spez1998/3rd-year-project/Submissions/constructed_pyle.jpeg

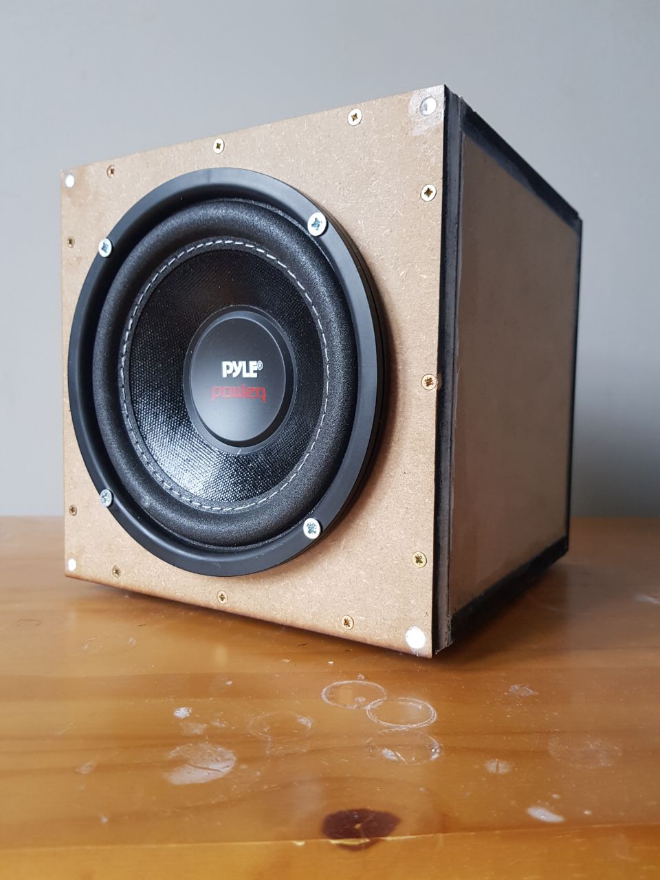
Submissions/constructed_pyle.jpeg
