spez1998/3rd-year-project/Design/SubsystemImages/PLPW6D.jpg

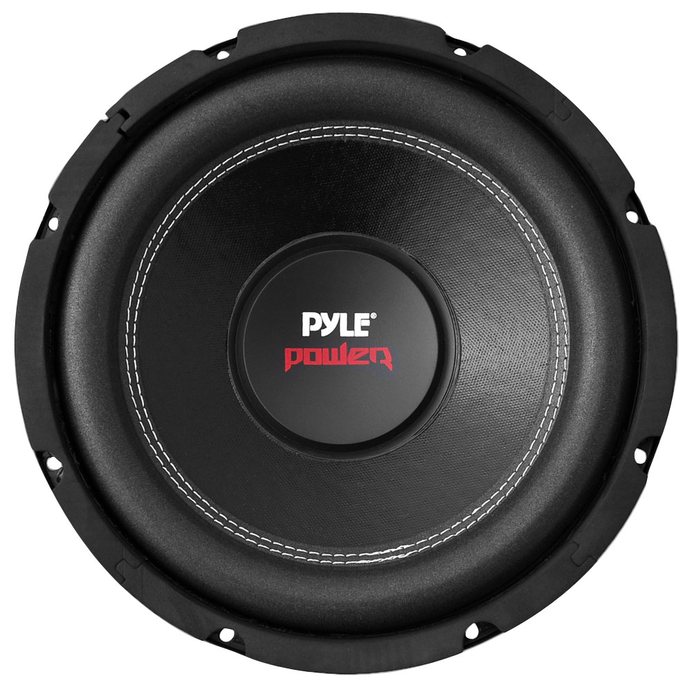
Design/SubsystemImages/PLPW6D.jpg
