spez1998/3rd-year-project/MeetingNotes/05_11_2019.docx

- Add opamp buffer between Linkwitz filters and speaker outputs.
- 196 ohm resistor exists to prevent short-circuited output from causing damage to filters
- Cable capacitance effects can also be mitigated by 196 ohm
