spez1998/3rd-year-project/Submissions/2ndMarkerViva/viva_presentation.pptx

## Motional Control of Loudspeakers

Sujit Malde, ela17sm, Electrical and Electronic Engineering 3rd Year Project
Second Marker Viva

## The Problem with Loudspeakers

- Not normally controlled
- Distortions and non-linearities are rife
- Expensive
  - Manufacturers must spend lots to make loudspeakers ‘perfect’
  - Most consumers can’t buy good audio

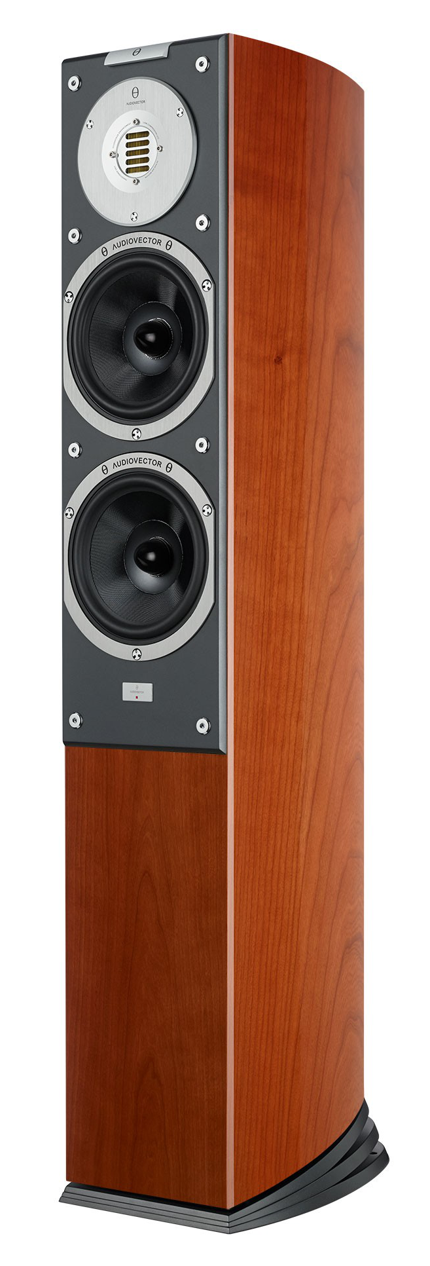
[picture p3: figure]

https://audiovector.com/sr-3-avantgarde-arrete.html

£12000 excluding rest of the system!

## The Problem with Loudspeakers

- Background theory shows that:
  - Subwoofers have the most non-linearities of all the loudspeakers
  - Subwoofers can have their bass response extended ’for free’
- Manufacturers already spending lots on R&D to make uncompensated systems sound good

Shown: typical poor subwoofer response, -15dB down at 20Hz

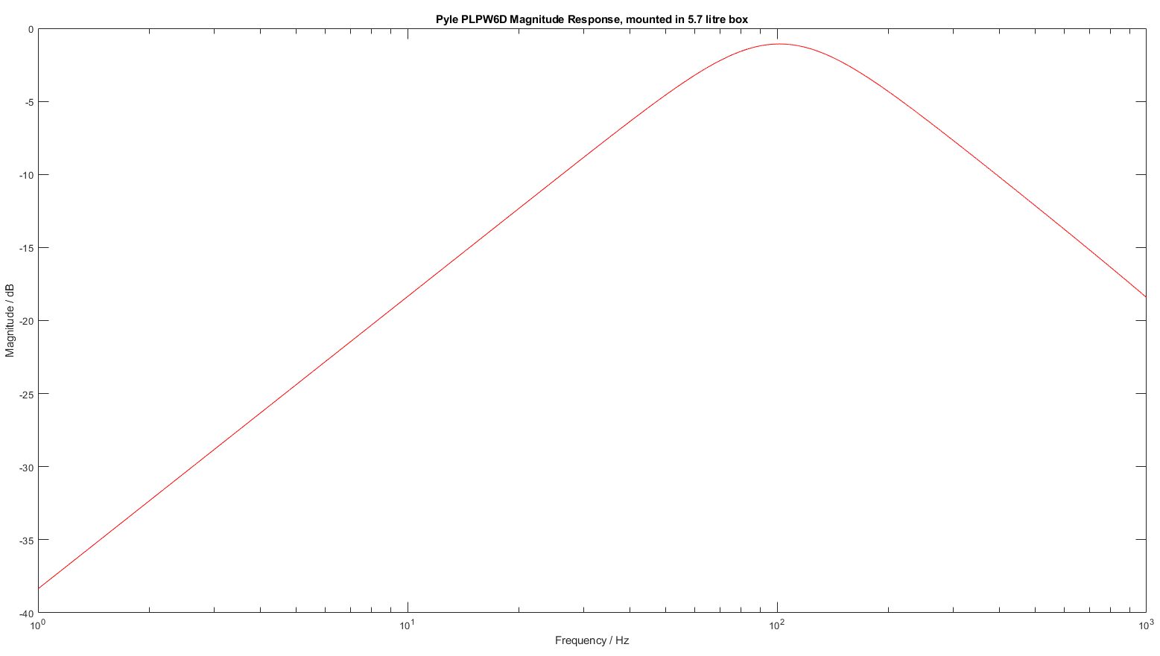
[picture p4: figure]

Frequency / Hz

10⁰

10¹

10²

10³

## The solution

- Open- and closed-loop compensators
- Electronic solution is cheap, easy to manufacture and install
- Fewer distortions, fewer non-linearities = cleaner sound reproductions
- ‘Free’ extension of bass response = better sound from the same physical system

## The process

Ideally:
1. Choose a subwoofer
2. Make an enclosure for the subwoofer
3. Open-loop compensator:
  a. Design
  b. Build
4. Closed-loop compensator:
  a. Design
  b. Build
5. Testing and tuning throughout

## Choosing a subwoofer

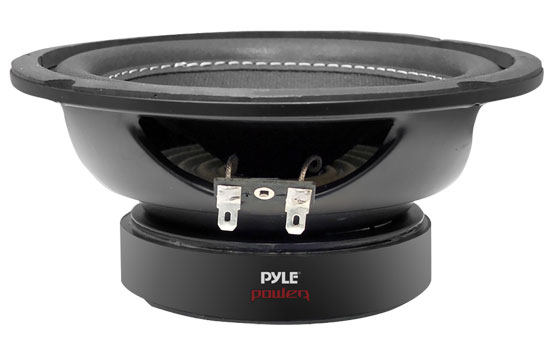
[picture p5: figure]

https://www.thompsonsltd.co.uk/touring-and-leisure/plpw6d-pyle-plpw6d-6.5-600-watt-dual-voice-coil-4-ohm-subwoofer.html

## Enclosure design

- Background theory shows that loudspeakers can be modelled as equivalent electrical circuits:

V_(in)

I

(C_(MS))/((Bl)^2)

(C_B)/((Bl)^2)

((Bl)^2)/(R_(MS))

((Bl)^2)/(R_B)

R_E

L_E

M_(MS) (Bl^2 )

Electrical and mechanical circuits can be thought of as primary and secondary of a transformer with turns ratio equivalent to Bl factor of driver magnet
Useful for SPICE/MATLAB but not easy information for end-users to digest – Thiele/Small parameters used instead

Red indicates voice coil circuit parameters
Blue indicates equivalent circuit parameters for the driver mechanical circuit
Green indicates equivalent circuit parameters for the box mechanical circuit

## Enclosure Design

1. Take T/S parameters from manufacturer
2. Convert to electromechanical equivalent circuit
3. Add in box circuit elements
4. Refine

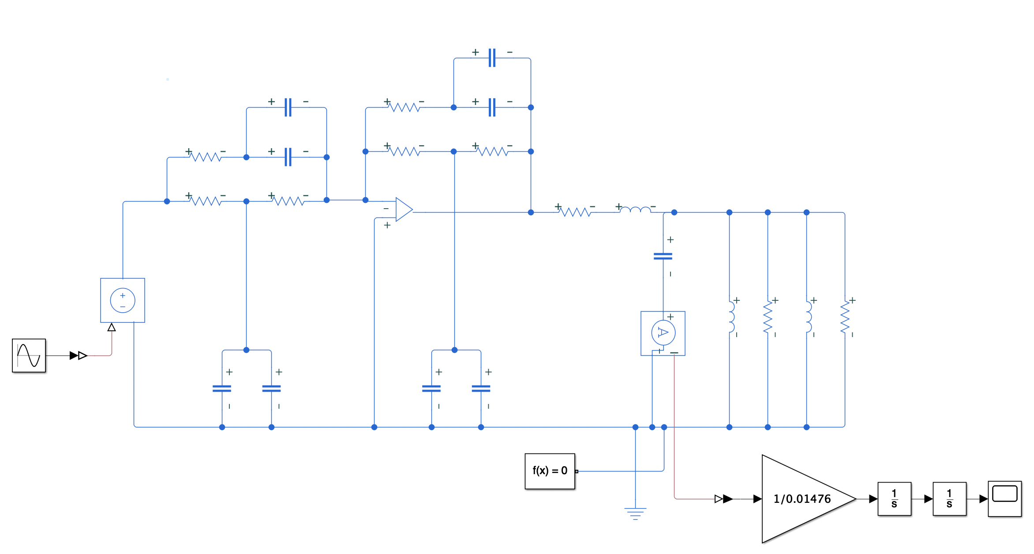
[picture p6: figure]

## Impedance Measurements

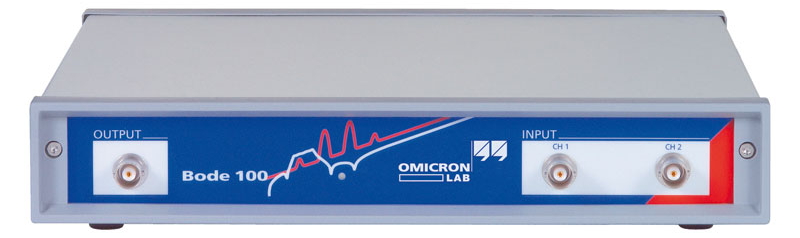
[picture p7: figure]
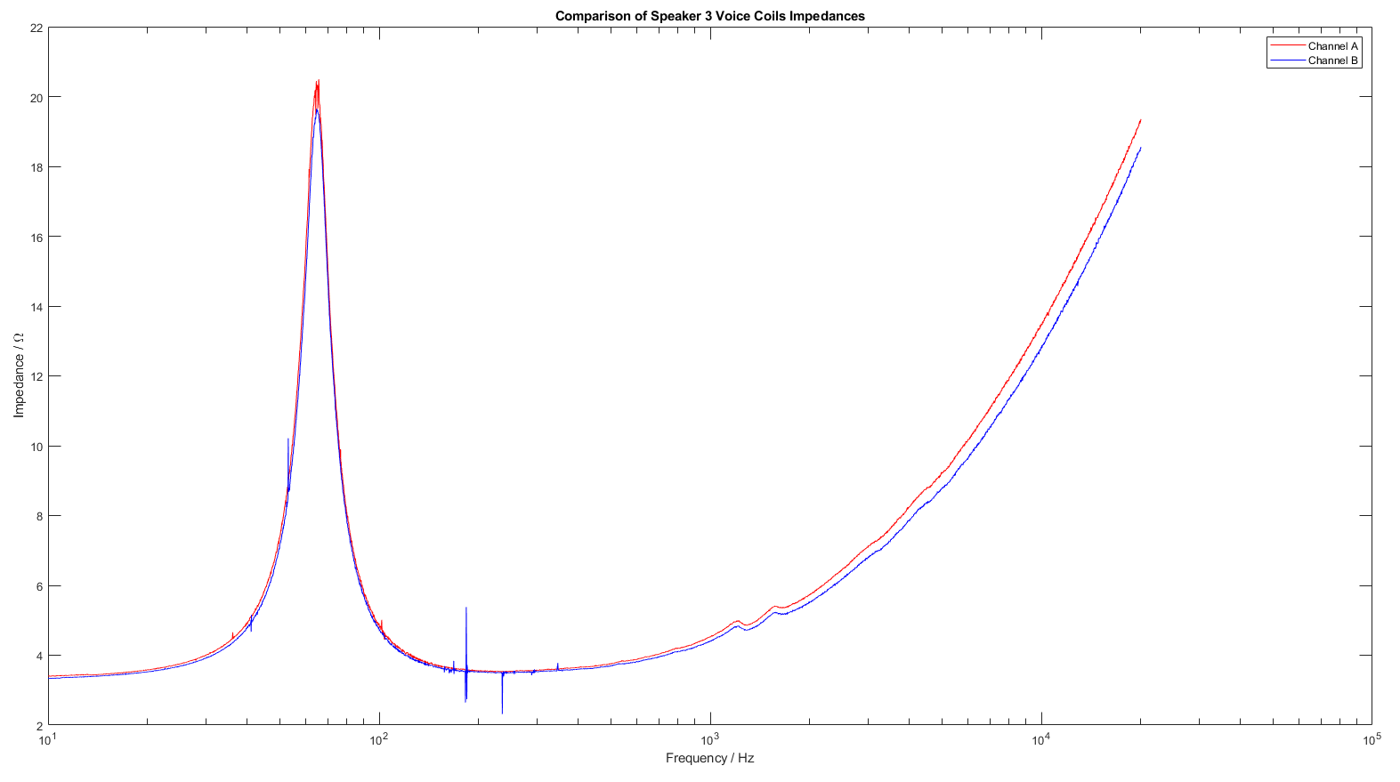
[picture p8: figure]

- All different permutation of connections were made and measured:
  - Series
  - Parallel (in 1 out 2)
  - Anti-parallel (in 2 out 1)
- Replace manufacturer given T/S parameters with these – also yields more accurate Bl

## Slide 10

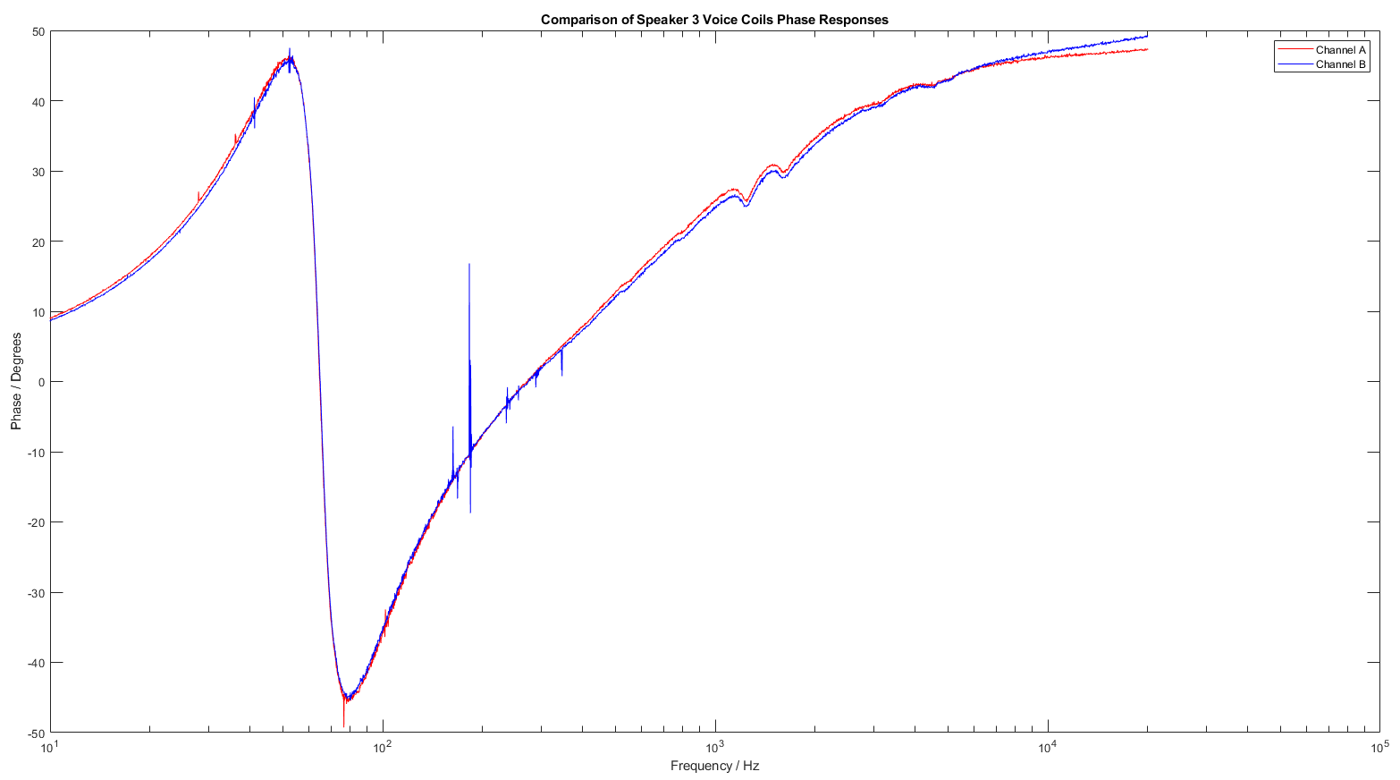
[picture p9: figure]

## Open-loop circuit design – Linkwitz Transform

- For a loudspeaker in an enclosure:
  - Brings up magnitude response
  - Reduces group delay
- Easy to design, made trivial using resources on the late designer’s website

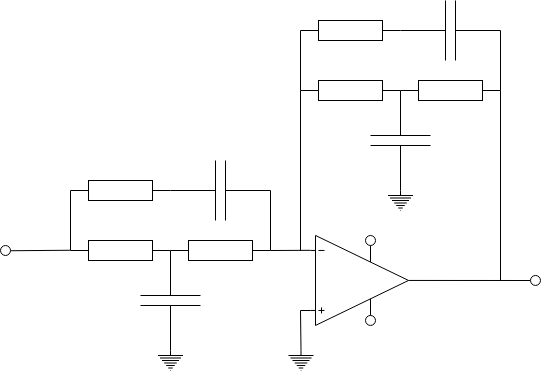
[picture p10: figure]

V_(in)

R_2

+V_s

−V_s

V_(out)

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
Gain / dB

f2

f1

f0

Frequency / Hz

Q0

f_0 =1/(2πR_1 √(C_1 C_2))
Q_0 =(R_1)/(2R_1 +R_2)√((C_1)/(C_2))
f_1 =1/(πR_1 C_1)
f_2 =1/(2π(R_2 +R_3 )C_2)

## Results

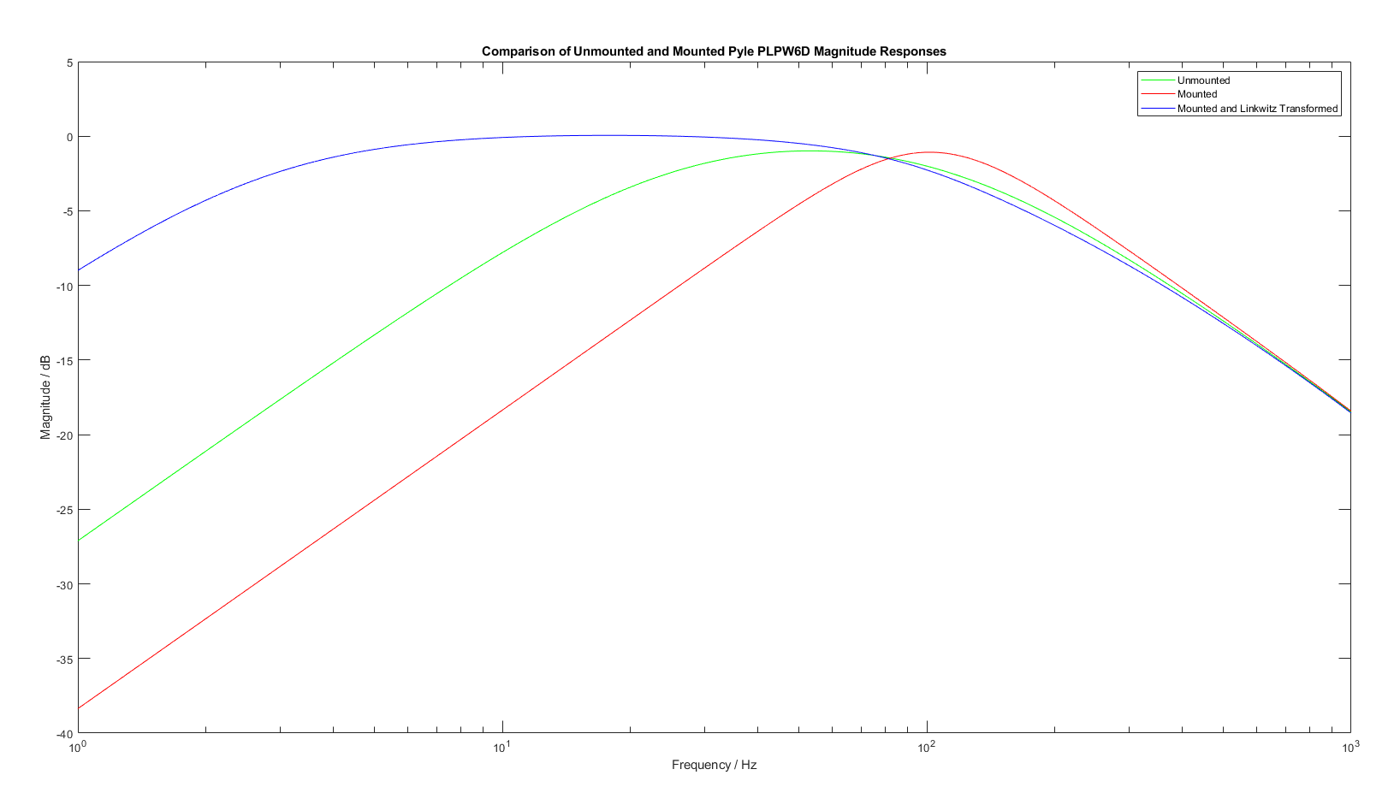
[picture p11: figure]

- Group delay of the system improved for most of the range of operation
- Improvement by as much as 2ms around 45Hz
- System will respond faster to an input, reach a nominal value faster

As expected, magnitude response improved massively at low frequencies
In practice this is unobtainable because too much air needs to be moved, cone displacement will exceed maximum allowed value

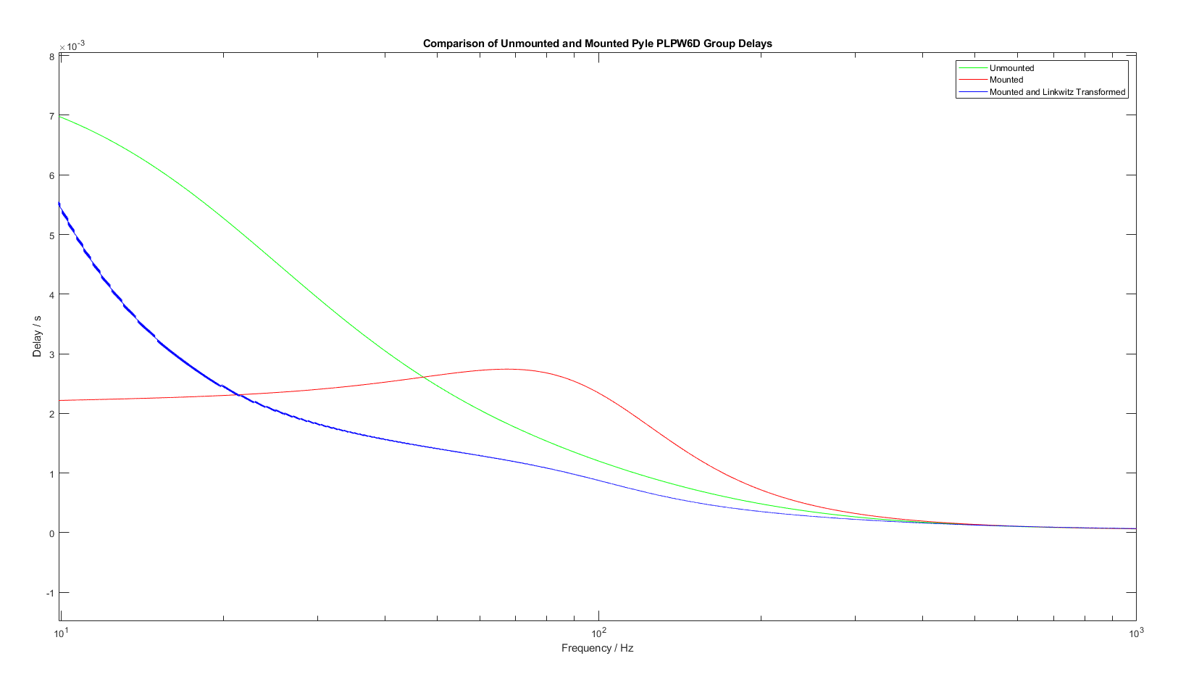
[picture p12: figure]

## Results

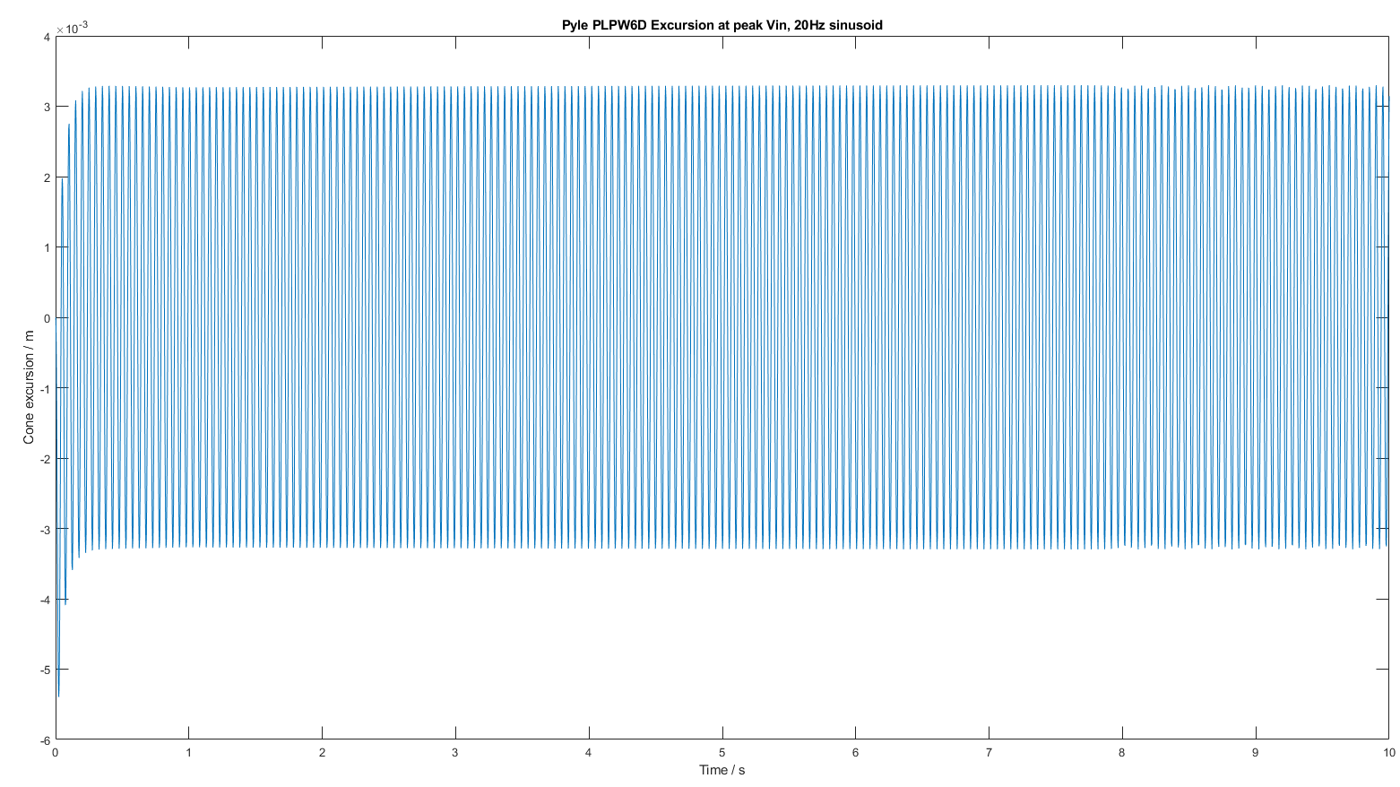
[picture p13: figure]

- Simulink model confirms that existing setup of Linkwitz Transform, driver, box does not exceed physical limitations
- Important result – LT may not have worked for this driver

## Plans

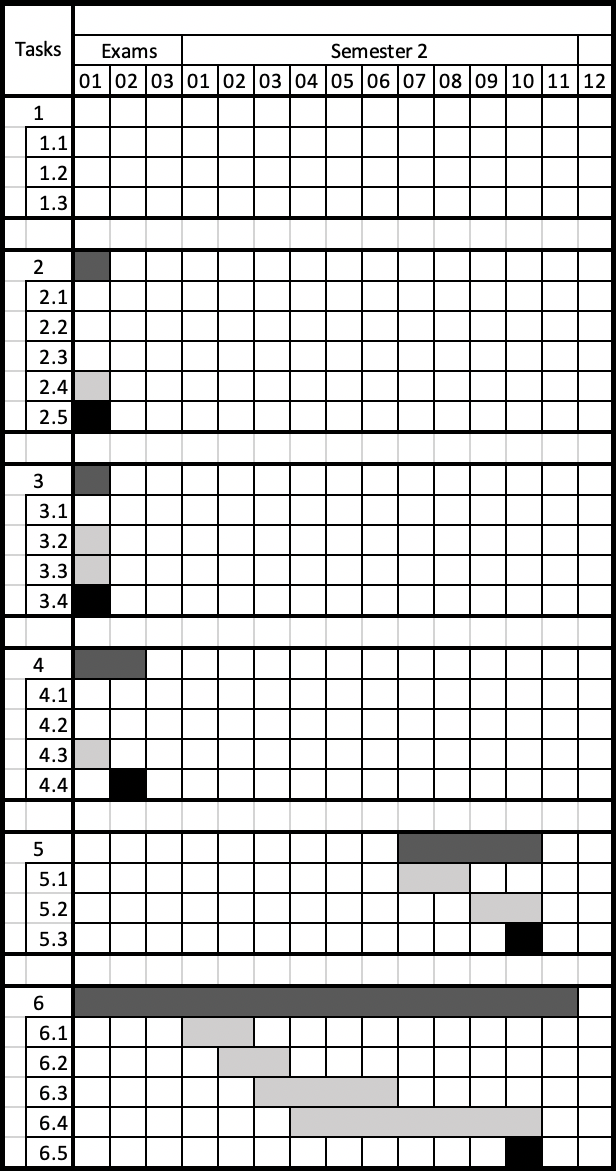
[picture p14: figure]

- Finish building subwoofer system
- Make and test open-loop compensator
- Design, simulate, build closed-loop compensators

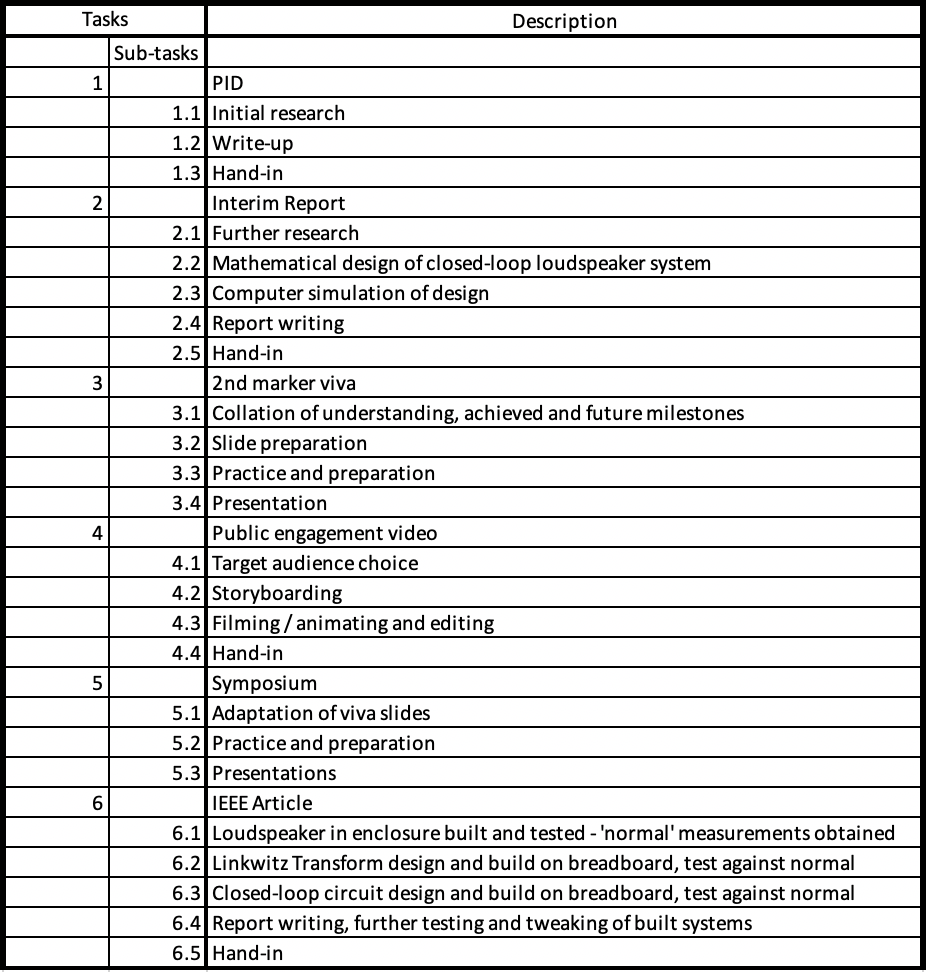
[picture p15: figure]
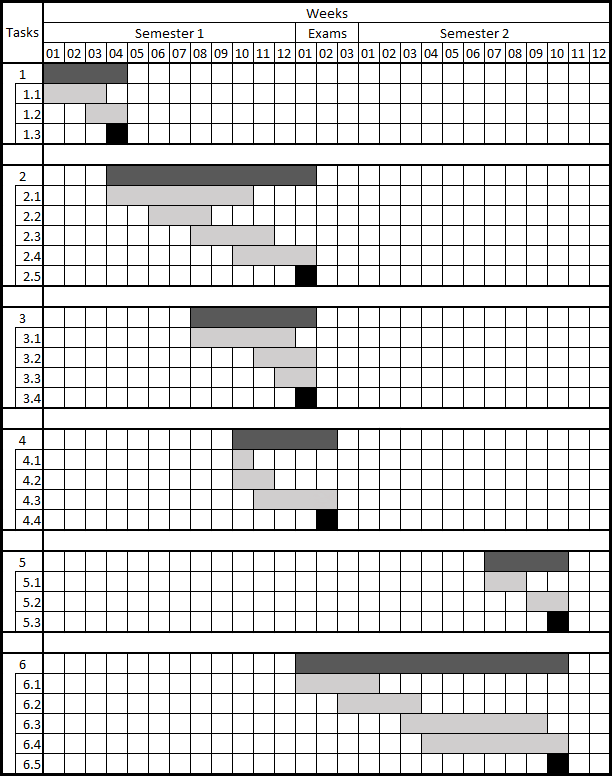
[picture p16: figure]

## Developing Technologies

- FPAA (e.g. as made by Anadigm) - easy interfacing with MATLAB/Simulink, mini DSP
- Different loudspeaker types other than simple coil-and-cone:
  - Electrostatic topology
  - Planar magnetic topology
Each has their own advantages and disadvantages
- Most useful innovations are patented!

## Slide 16

Thank you for listening, any questions?
