spez1998/3rd-year-project/Design/OpenLoop/LinkwitzLabsResources/Originals/spl_max1.xls

A) Excursion limited rms sound pressure level (SPL) for a driver in a closed box (monopole)
and in an open baffle (dipole) at 1 m distance on-axis, in free-space
Enter bold faced values for the driver under investigation, path difference and start frequency:
Add 6 dB to SPL for radiation into half-space.
 |  |  | 1252DVC | 21W/8554
 |  |  | Driver A | Driver B
 |  | Effective piston area Sd = | 530 | 200 | cm^2
 |  | Peak excursion Xmax = | 6 | 6.5 | mm
 |  | Effective path difference D = | 483 | 248 | mm
 |  | Effective piston diameter d = | 259.7723924 | 159.5769122 | mm
 |  | Volume displacement Vp = | 318 | 130 | cm^3
 |  | SPL dipole=monopole at Fequal = | 120.7246377 | 235.1209677 | Hz
 |  | SPL (at Fequal) = | 115.7391811 | 119.5493238 | dB
 |  | Monopole SPL at 100 Hz = | 112.4673447 | 104.6976693 | dB
 |  | Dipole SPL at 100 Hz = | 110.8314265 | 97.27184212 | dB
Frequency | mono A | dipole A | mono B | dipole B
Hz | dB SPL | dB SPL | dB SPL | dB SPL
25 | 88.38494503 | 74.70782699 | 80.61526968 | 61.14824264
35.35533906 | 94.40554495 | 83.73872686 | 86.63586959 | 70.17914251
50 | 100.4261449 | 92.76962673 | 92.65646951 | 79.21004238
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
