spez1998/3rd-year-project/Submissions/2ndMarkerViva/viva_feedback.docx

- Make waveform comparison more clear for non-specialists – make it obvious
