spez1998/3rd-year-project/Submissions/EngVideo/video_animation.pptx

## Public Engagement Video

Sujit Malde, ela17sm, Electrical and Electronic Engineering 3rd Year Project
Target audience: Venture Capitalists

## Slide 2

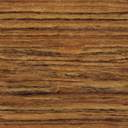
[picture p45: figure]

Uncontrolled speakers haven’t got the best sound response.

## Slide 3

Larger error margin

Easier to build

More uncertainty over time

## Slide 4

PREMIUM PRICE POINTS

Bass Enthusiasts

Traditional Subwoofer Markets

Audiophiles

Live Music Venues

Music
Production
Studios

Cinemas

## Slide 5

Electronic solutions:
- Same cheaper hardware plus cheap electronics means cheaper unit but better sound
- Easy for end-users to implement – simple but attractive solution
- Can mitigate lifelong changes to speaker’s properties
- Applies to other similar electromechanical systems

PREMIUM PRICE POINTS

Notes: Quicker than re-designing speakers
Easier than rebuilding for end-users
Sell as a scientifically-proven add-on to make existing systems better – potential for large premium to be applied

## Slide 6

Bass Enthusiasts

Traditional Subwoofer Markets

Live Music Venues

Huge Untapped Market

Cinemas

Music Production Studios

Similar Mechanical Setups

## Slide 7
