spez1998/3rd-year-project/Submissions/EngVideo/PEV_storyboard_ela17sm.pdf

Name: Sujit Malde | Registration Number: 170170655

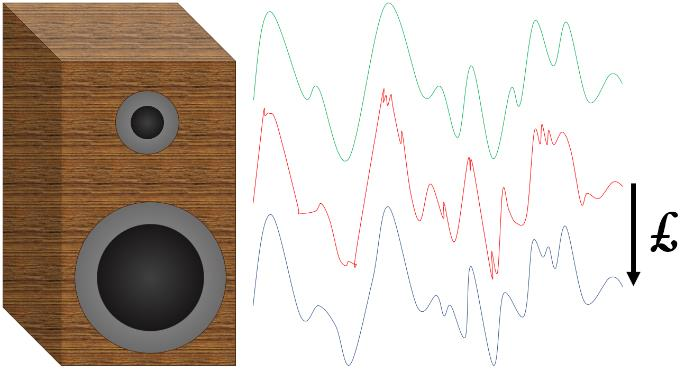
[picture p46: figure]
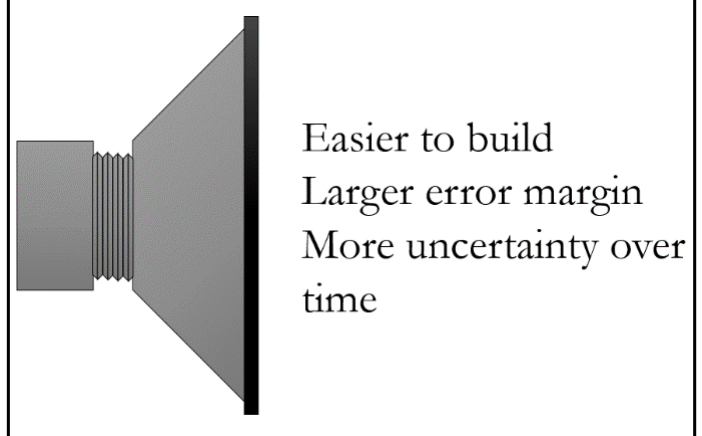
[picture p47: figure]
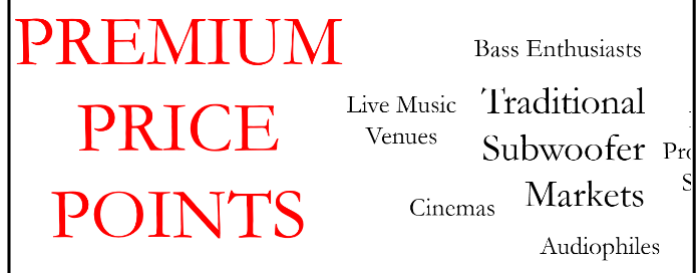
[picture p48: figure]

22/01/2020 | 1
Explain | how | nearly | all
loudspeakers are run without
compensation | and | are
therefore sound quality is tied directly to the quality of the system.

Describe why subwoofers
are most in need of the
solution to be presented
from their physics.

Even though subwoofers have a larger potential market, high quality and high-priced systems
preferred | by | manufacturers
because people aren’t willing to
pay | for | mediocre-sounding
systems – either very cheap for mediocre sound or premium for premium sound.

Name: Sujit Malde | Registration Number: 170170655

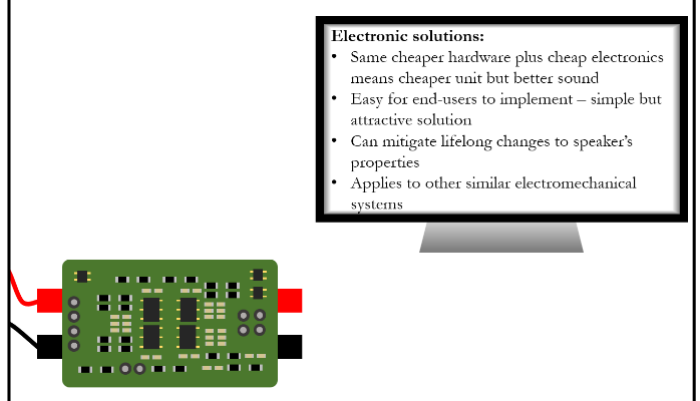
[picture p49: figure]
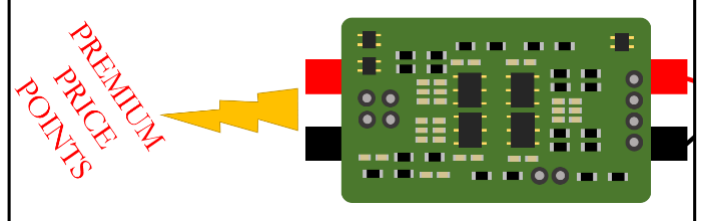
[picture p50: figure]
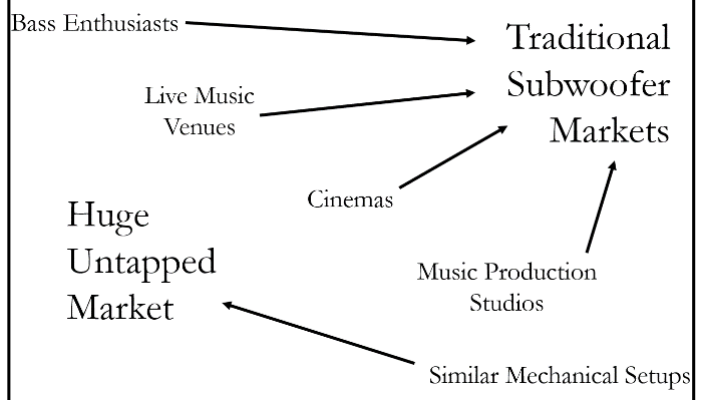
[picture p51: figure]

22/01/2020 | 2

Describe how cutting-edge
research has allowed cheap electronics to extend and
improve the response of a
subwoofer. Highlight how
the solution can be used for similar electromechanical
systems.

Hammer home the point that cheap electronics will help manufacturers deliver highquality systems at lower price points.

Restate the potential market for subwoofers, including the potential addition of similar mechanical setups. Mention the possibility of selling stand-alone controllers.
Mention guaranteed return
on investment.
