spez1998/3rd-year-project/Submissions/InterimReport/GanntChart/gantt_chart_amended.xlsx

Tasks
 |  | Exams |  |  | Semester 2
 |  | 01 | 02 | 03 | 01 | 02 | 03 | 04 | 05 | 06 | 07 | 08 | 09 | 10 | 11 | 12
1
 | 1.1
 | 1.2
 | 1.3
2
 | 2.1
 | 2.2
 | 2.3
 | 2.4
 | 2.5
3
 | 3.1
 | 3.2
 | 3.3
 | 3.4
4
 | 4.1
 | 4.2
 | 4.3
 | 4.4
5
 | 5.1
 | 5.2
 | 5.3
6
 | 6.1
 | 6.2
 | 6.3
 | 6.4
 | 6.5
 |  |  |  |  |  |  |  |  |  |  |  |  |  |  |  |  | Tasks |  | Description
 |  |  |  |  |  |  |  |  |  |  |  |  |  |  |  |  |  | Sub-tasks
 |  |  |  |  |  |  |  |  |  |  |  |  |  |  |  |  | 1 |  | PID
 |  |  |  |  |  |  |  |  |  |  |  |  |  |  |  |  |  | 1.1 | Initial research
 |  |  |  |  |  |  |  |  |  |  |  |  |  |  |  |  |  | 1.2 | Write-up
 |  |  |  |  |  |  |  |  |  |  |  |  |  |  |  |  |  | 1.3 | Hand-in
 |  |  |  |  |  |  |  |  |  |  |  |  |  |  |  |  | 2 |  | Interim Report
 |  |  |  |  |  |  |  |  |  |  |  |  |  |  |  |  |  | 2.1 | Further research
 |  |  |  |  |  |  |  |  |  |  |  |  |  |  |  |  |  | 2.2 | Mathematical design of closed-loop loudspeaker system
 |  |  |  |  |  |  |  |  |  |  |  |  |  |  |  |  |  | 2.3 | Computer simulation of design
 |  |  |  |  |  |  |  |  |  |  |  |  |  |  |  |  |  | 2.4 | Report writing
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
