spez1998/3rd-year-project/Design/OpenLoop/LinkwitzLabsResources/closed_box.xls

Sheet: Spec's
Closed box woofer design |  |  |  |  |  |  |  | Revision | 7/16/01 SL | 3/9/03 SL
(Replace bold faced numbers with your own data) |  |  |  |  | © LINKWITZ LAB |  |  |  | 7/2/02 SL | 5/2/03 SL
1 - Driver data |  |  |  |  |  | 2 - Box data |  |  | 4 - Driver in box model |  |  |  | 7 - Power amplifier spec's |  |  |  | Conversions
Model = | Pyle PLPW6D 6" |  |  |  |  | Int. vol. = | 5.7367 | ltr | Re = | 3.4 | ohm |  | P = | 10 | W |  | 47 | ltr --> | 2867.94 | in^3
Re = | 3.4 | ohm * | * = required parameters |  |  | Qb = | 50 |  | Le = | 0.1488 | mH |  | Rload = | 4 | ohm |  | 3051 | in^3 --> | 50.0 | ltr
Le = | 0.1488 | mH * |  |  |  |  |  |  | C = | 388.7 | uF |  | Imax = | 2 | A |  | 2868 | in^3 --> | 1.66 | ft^3
Fs = | 52.2 | Hz | 52.2 | Hz |  | Cmb = | 0.24 | mm/N | L = | 6.5 | mH |  |  |  |  |  | 1.77 | ft^3 --> | 50.1 | ltr
Bl = | 6.16 | N/A * |  |  |  | Leb = | 9.0 | mH | R = | 25.9 | ohm |  | Vpeak = | 8.9 | V @ Rload |  | 3500 | ft^3 --> | 99.1 | m^3
Qms = | 3.6253 |  | 3.64 |  |  | Rmb = | 0.13 | Ns/m |  |  |  |  | Ipeak = | 2.2 | A @ Rload
Qes = | 0.4336 |  | 0.43 |  |  | Reb = | 281.9650659 | ohm | 5 - Target response
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
