spez1998/3rd-year-project/Design/OpenLoop/LinkwitzLabsResources/lt_designer.xls

Equalizer with complex poles and zeros |  |  |  |  |  |  |  | © LINKWITZ LAB - 26 October 2000
Enter your own values for the numbers in bold typeface
Values are in Hz, kOhm and nF
Measure f0, Q0 using < f0Q0.gif > |  |  | 1) Specify: |  |  | 3b) Calculated poles & zeros |  |  | 4b) Calculated poles & zeros
Choose target for fp, Qp |  |  | f0 = | 74.2 |  | f0 | 73.41270096 |  | f0 | 73.32987841
 |  |  | Q0 = | 0.55 |  | Q0 | 1.87 |  | Q0 | 2.14
Component layout |  |  | fp = | 20 |  | fp | 21.18746051 |  | fp | 21.16344208
R2 ----- C2 |  | R2 ----- C2 | Qp = | 0.7 |  | Qp | 0.65 |  | Qp | 0.73
R1 ----- R1 |  | R3 ----- R3 | C2 = | 100.0 |  | fp1 | 31.83098862 |  | fp1 | 28.31434675
C1 |  | C3 |  |  |  | fz1 | 32.08122215 | = fp1 ?? | fz1 | 28.56846941 | = fp1 ??
 |  |  |  |  |  | Adc [dB] | 21.6 |  | Adc [dB] | 21.6
For realizability with the given
circuit k must be positive. |  |  | 2b) Multiply calculated |  |  |  | Find the optimum standard value combination
 |  |  | values by M to change |  |  |  | that approximates the specified poles and zeros
2a) Calculated values |  |  | impedance level
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
