spez1998/3rd-year-project/Design/OpenLoop/LinkwitzLabsResources/Originals/closed-box1-1.xls

Sheet: Spec's
Closed box woofer design |  |  |  |  |  |  |  | Revision | 7/16/01 SL | 3/9/03 SL
(Replace bold faced numbers with your own data) |  |  |  |  | © LINKWITZ LAB |  |  |  | 7/2/02 SL | 5/2/03 SL
1 - Driver data |  |  |  |  |  | 2 - Box data |  |  | 4 - Driver in box model |  |  |  | 7 - Power amplifier spec's |  |  |  | Conversions
Model = | Peerless 830500 - XLS 12" |  |  |  |  | Int. vol. = | 47 | ltr | Re = | 3.5 | ohm |  | P = | 180 | W |  | 47 | ltr --> | 2867.94 | in^3
Re = | 3.5 | ohm * | * = required parameters |  |  | Qb = | 50 |  | Le = | 4.2 | mH |  | Rload = | 8 | ohm |  | 3051 | in^3 --> | 50.0 | ltr
Le = | 4.2 | mH * |  |  |  |  |  |  | C = | 536.9 | uF |  | Imax = | 12 | A |  | 2868 | in^3 --> | 1.66 | ft^3
Fs = | 18.1 | Hz | 18.2 | Hz |  | Cmb = | 0.15 | mm/N | L = | 35.6 | mH |  |  |  |  |  | 1.77 | ft^3 --> | 50.1 | ltr
Bl = | 17.6 | N/A * |  |  |  | Leb = | 47.5 | mH | R = | 54.4 | ohm |  | Vpeak = | 53.5 | V @ Rload |  | 3500 | ft^3 --> | 99.1 | m^3
Qms = | 3.7 |  | 3.71 |  |  | Rmb = | 0.57 | Ns/m |  |  |  |  | Ipeak = | 6.7 | A @ Rload
Qes = | 0.21 |  | 0.21 |  |  | Reb = | 542.9837702 | ohm | 5 - Target response
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
