spez1998/3rd-year-project/Design/OpenLoop/Plots/OLD/RawData/mounted_pyle_lt.csv

Frequency | Magnitude | Phase
1.0000 | -8.9949 | -111.5175
1.0002 | -8.9931 | -111.5217
1.0005 | -8.9914 | -111.5259
1.0007 | -8.9896 | -111.5301
1.0009 | -8.9879 | -111.5343
1.0012 | -8.9861 | -111.5385
1.0014 | -8.9843 | -111.5427
1.0016 | -8.9826 | -111.5469
1.0018 | -8.9808 | -111.5511
1.0021 | -8.9791 | -111.5553
1.0023 | -8.9773 | -111.5595
1.0025 | -8.9755 | -111.5637
1.0028 | -8.9738 | -111.5679
1.0030 | -8.9720 | -111.5721
1.0032 | -8.9703 | -111.5763
1.0035 | -8.9685 | -111.5805
1.0037 | -8.9667 | -111.5847
1.0039 | -8.9650 | -111.5889
1.0042 | -8.9632 | -111.5931
1.0044 | -8.9615 | -111.5973
1.0046 | -8.9597 | -111.6015
1.0048 | -8.9579 | -111.6057
1.0051 | -8.9562 | -111.6100
1.0053 | -8.9544 | -111.6142
1.0055 | -8.9527 | -111.6184
1.0058 | -8.9509 | -111.6226
1.0060 | -8.9491 | -111.6268
1.0062 | -8.9474 | -111.6310
1.0065 | -8.9456 | -111.6352
1.0067 | -8.9439 | -111.6395
1.0069 | -8.9421 | -111.6437
1.0072 | -8.9403 | -111.6479
1.0074 | -8.9386 | -111.6521
1.0076 | -8.9368 | -111.6563
1.0079 | -8.9351 | -111.6606
1.0081 | -8.9333 | -111.6648
1.0083 | -8.9315 | -111.6690
1.0086 | -8.9298 | -111.6732
1.0088 | -8.9280 | -111.6774
1.0090 | -8.9263 | -111.6817
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
