spez1998/3rd-year-project/Design/OpenLoop/Plots/OLD/RawData/mounted_pyle.csv

Frequency | Magnitude | Phase
1.00000000000000e+00 | -3.83602112066253e+01 | 8.83607387448059e+01
1.00023028502082e+00 | -3.83582117188799e+01 | 8.83607481827007e+01
1.00046062307284e+00 | -3.83562122308854e+01 | 8.83607575337126e+01
1.00069101416826e+00 | -3.83542127426421e+01 | 8.83607667978420e+01
1.00092145831930e+00 | -3.83522132541500e+01 | 8.83607759750883e+01
1.00115195553817e+00 | -3.83502137654093e+01 | 8.83607850654529e+01
1.00138250583710e+00 | -3.83482142764200e+01 | 8.83607940689365e+01
1.00161310922831e+00 | -3.83462147871823e+01 | 8.83608029855391e+01
1.00184376572403e+00 | -3.83442152976963e+01 | 8.83608118152609e+01
1.00207447533648e+00 | -3.83422158079620e+01 | 8.83608205581031e+01
1.00230523807790e+00 | -3.83402163179796e+01 | 8.83608292140655e+01
1.00253605396052e+00 | -3.83382168277492e+01 | 8.83608377831482e+01
1.00276692299659e+00 | -3.83362173372709e+01 | 8.83608462653528e+01
1.00299784519833e+00 | -3.83342178465448e+01 | 8.83608546606787e+01
1.00322882057800e+00 | -3.83322183555711e+01 | 8.83608629691263e+01
1.00345984914784e+00 | -3.83302188643497e+01 | 8.83608711906969e+01
1.00369093092010e+00 | -3.83282193728809e+01 | 8.83608793253900e+01
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
