spez1998/3rd-year-project/Design/OpenLoop/Plots/OLD/RawData/OLD/dual_full_lt_pyle_notch_tl074.csv

Frequency | Magnitude | Phase
1.00E+00 | -2.79E+01 | 8.32E+01
1.00E+00 | -2.79E+01 | 8.32E+01
1.00E+00 | -2.79E+01 | 8.32E+01
1.00E+00 | -2.79E+01 | 8.32E+01
1.00E+00 | -2.79E+01 | 8.32E+01
1.00E+00 | -2.79E+01 | 8.32E+01
1.00E+00 | -2.79E+01 | 8.32E+01
1.00E+00 | -2.79E+01 | 8.32E+01
1.00E+00 | -2.79E+01 | 8.32E+01
1.00E+00 | -2.79E+01 | 8.32E+01
1.00E+00 | -2.79E+01 | 8.32E+01
1.00E+00 | -2.79E+01 | 8.32E+01
1.00E+00 | -2.79E+01 | 8.32E+01
1.00E+00 | -2.79E+01 | 8.32E+01
1.00E+00 | -2.79E+01 | 8.32E+01
1.00E+00 | -2.79E+01 | 8.32E+01
1.00E+00 | -2.79E+01 | 8.32E+01
1.00E+00 | -2.79E+01 | 8.32E+01
1.00E+00 | -2.79E+01 | 8.32E+01
1.00E+00 | -2.79E+01 | 8.32E+01
1.00E+00 | -2.78E+01 | 8.32E+01
1.00E+00 | -2.78E+01 | 8.32E+01
1.01E+00 | -2.78E+01 | 8.32E+01
1.01E+00 | -2.78E+01 | 8.32E+01
1.01E+00 | -2.78E+01 | 8.31E+01
1.01E+00 | -2.78E+01 | 8.31E+01
1.01E+00 | -2.78E+01 | 8.31E+01
1.01E+00 | -2.78E+01 | 8.31E+01
1.01E+00 | -2.78E+01 | 8.31E+01
1.01E+00 | -2.78E+01 | 8.31E+01
1.01E+00 | -2.78E+01 | 8.31E+01
1.01E+00 | -2.78E+01 | 8.31E+01
1.01E+00 | -2.78E+01 | 8.31E+01
1.01E+00 | -2.78E+01 | 8.31E+01
1.01E+00 | -2.78E+01 | 8.31E+01
1.01E+00 | -2.78E+01 | 8.31E+01
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
