spez1998/3rd-year-project/Design/OpenLoop/Plots/OLD/RawData/OLD/10-100/basic_pyle.csv

Frequency | Magnitude | Phase
1.00E+01 | -1.67E+01 | 4.00E+01
1.00E+01 | -1.67E+01 | 4.00E+01
1.00E+01 | -1.67E+01 | 4.00E+01
1.00E+01 | -1.67E+01 | 4.00E+01
1.00E+01 | -1.67E+01 | 4.00E+01
1.00E+01 | -1.67E+01 | 4.00E+01
1.00E+01 | -1.67E+01 | 4.00E+01
1.00E+01 | -1.67E+01 | 3.99E+01
1.00E+01 | -1.67E+01 | 3.99E+01
1.00E+01 | -1.67E+01 | 3.99E+01
1.00E+01 | -1.67E+01 | 3.99E+01
1.00E+01 | -1.67E+01 | 3.99E+01
1.00E+01 | -1.67E+01 | 3.99E+01
1.00E+01 | -1.67E+01 | 3.99E+01
1.00E+01 | -1.67E+01 | 3.99E+01
1.00E+01 | -1.67E+01 | 3.99E+01
1.00E+01 | -1.67E+01 | 3.99E+01
1.00E+01 | -1.67E+01 | 3.99E+01
1.00E+01 | -1.67E+01 | 3.99E+01
1.00E+01 | -1.67E+01 | 3.99E+01
1.00E+01 | -1.67E+01 | 3.99E+01
1.00E+01 | -1.67E+01 | 3.99E+01
1.01E+01 | -1.67E+01 | 3.98E+01
1.01E+01 | -1.67E+01 | 3.98E+01
1.01E+01 | -1.67E+01 | 3.98E+01
1.01E+01 | -1.67E+01 | 3.98E+01
1.01E+01 | -1.67E+01 | 3.98E+01
1.01E+01 | -1.67E+01 | 3.98E+01
1.01E+01 | -1.67E+01 | 3.98E+01
1.01E+01 | -1.67E+01 | 3.98E+01
1.01E+01 | -1.66E+01 | 3.98E+01
1.01E+01 | -1.66E+01 | 3.98E+01
1.01E+01 | -1.66E+01 | 3.98E+01
1.01E+01 | -1.66E+01 | 3.98E+01
1.01E+01 | -1.66E+01 | 3.98E+01
1.01E+01 | -1.66E+01 | 3.98E+01
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
