spez1998/3rd-year-project/Design/OpenLoop/Plots/OLD/RawData/OLD/10-100/dual_full_lt_pyle.csv

Frequency | Magnitude | Phase
1.00E+01 | -9.72E+00 | 4.18E+01
1.00E+01 | -9.72E+00 | 4.18E+01
1.00E+01 | -9.72E+00 | 4.18E+01
1.00E+01 | -9.72E+00 | 4.18E+01
1.00E+01 | -9.72E+00 | 4.18E+01
1.00E+01 | -9.72E+00 | 4.17E+01
1.00E+01 | -9.71E+00 | 4.17E+01
1.00E+01 | -9.71E+00 | 4.17E+01
1.00E+01 | -9.71E+00 | 4.17E+01
1.00E+01 | -9.71E+00 | 4.17E+01
1.00E+01 | -9.71E+00 | 4.17E+01
1.00E+01 | -9.71E+00 | 4.17E+01
1.00E+01 | -9.71E+00 | 4.17E+01
1.00E+01 | -9.71E+00 | 4.17E+01
1.00E+01 | -9.70E+00 | 4.17E+01
1.00E+01 | -9.70E+00 | 4.16E+01
1.00E+01 | -9.70E+00 | 4.16E+01
1.00E+01 | -9.70E+00 | 4.16E+01
1.00E+01 | -9.70E+00 | 4.16E+01
1.00E+01 | -9.70E+00 | 4.16E+01
1.00E+01 | -9.70E+00 | 4.16E+01
1.00E+01 | -9.70E+00 | 4.16E+01
1.01E+01 | -9.69E+00 | 4.16E+01
1.01E+01 | -9.69E+00 | 4.16E+01
1.01E+01 | -9.69E+00 | 4.16E+01
1.01E+01 | -9.69E+00 | 4.16E+01
1.01E+01 | -9.69E+00 | 4.15E+01
1.01E+01 | -9.69E+00 | 4.15E+01
1.01E+01 | -9.69E+00 | 4.15E+01
1.01E+01 | -9.69E+00 | 4.15E+01
1.01E+01 | -9.68E+00 | 4.15E+01
1.01E+01 | -9.68E+00 | 4.15E+01
1.01E+01 | -9.68E+00 | 4.15E+01
1.01E+01 | -9.68E+00 | 4.15E+01
1.01E+01 | -9.68E+00 | 4.15E+01
1.01E+01 | -9.68E+00 | 4.15E+01
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
