spez1998/3rd-year-project/Design/OpenLoop/Plots/OLD/RawData/OLD/10-100/dual_full_lt_pyle_notch_tl074.csv

Frequency | Magnitude | Phase
1.00E+01 | -9.79E+00 | 3.60E+01
1.00E+01 | -9.79E+00 | 3.59E+01
1.00E+01 | -9.79E+00 | 3.59E+01
1.00E+01 | -9.79E+00 | 3.59E+01
1.00E+01 | -9.79E+00 | 3.59E+01
1.00E+01 | -9.79E+00 | 3.59E+01
1.00E+01 | -9.79E+00 | 3.59E+01
1.00E+01 | -9.79E+00 | 3.59E+01
1.00E+01 | -9.78E+00 | 3.59E+01
1.00E+01 | -9.78E+00 | 3.59E+01
1.00E+01 | -9.78E+00 | 3.58E+01
1.00E+01 | -9.78E+00 | 3.58E+01
1.00E+01 | -9.78E+00 | 3.58E+01
1.00E+01 | -9.78E+00 | 3.58E+01
1.00E+01 | -9.78E+00 | 3.58E+01
1.00E+01 | -9.78E+00 | 3.58E+01
1.00E+01 | -9.77E+00 | 3.58E+01
1.00E+01 | -9.77E+00 | 3.58E+01
1.00E+01 | -9.77E+00 | 3.58E+01
1.00E+01 | -9.77E+00 | 3.57E+01
1.00E+01 | -9.77E+00 | 3.57E+01
1.00E+01 | -9.77E+00 | 3.57E+01
1.01E+01 | -9.77E+00 | 3.57E+01
1.01E+01 | -9.77E+00 | 3.57E+01
1.01E+01 | -9.76E+00 | 3.57E+01
1.01E+01 | -9.76E+00 | 3.57E+01
1.01E+01 | -9.76E+00 | 3.57E+01
1.01E+01 | -9.76E+00 | 3.57E+01
1.01E+01 | -9.76E+00 | 3.57E+01
1.01E+01 | -9.76E+00 | 3.56E+01
1.01E+01 | -9.76E+00 | 3.56E+01
1.01E+01 | -9.76E+00 | 3.56E+01
1.01E+01 | -9.75E+00 | 3.56E+01
1.01E+01 | -9.75E+00 | 3.56E+01
1.01E+01 | -9.75E+00 | 3.56E+01
1.01E+01 | -9.75E+00 | 3.56E+01
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
