spez1998/3rd-year-project/Design/Plots/out_i.png

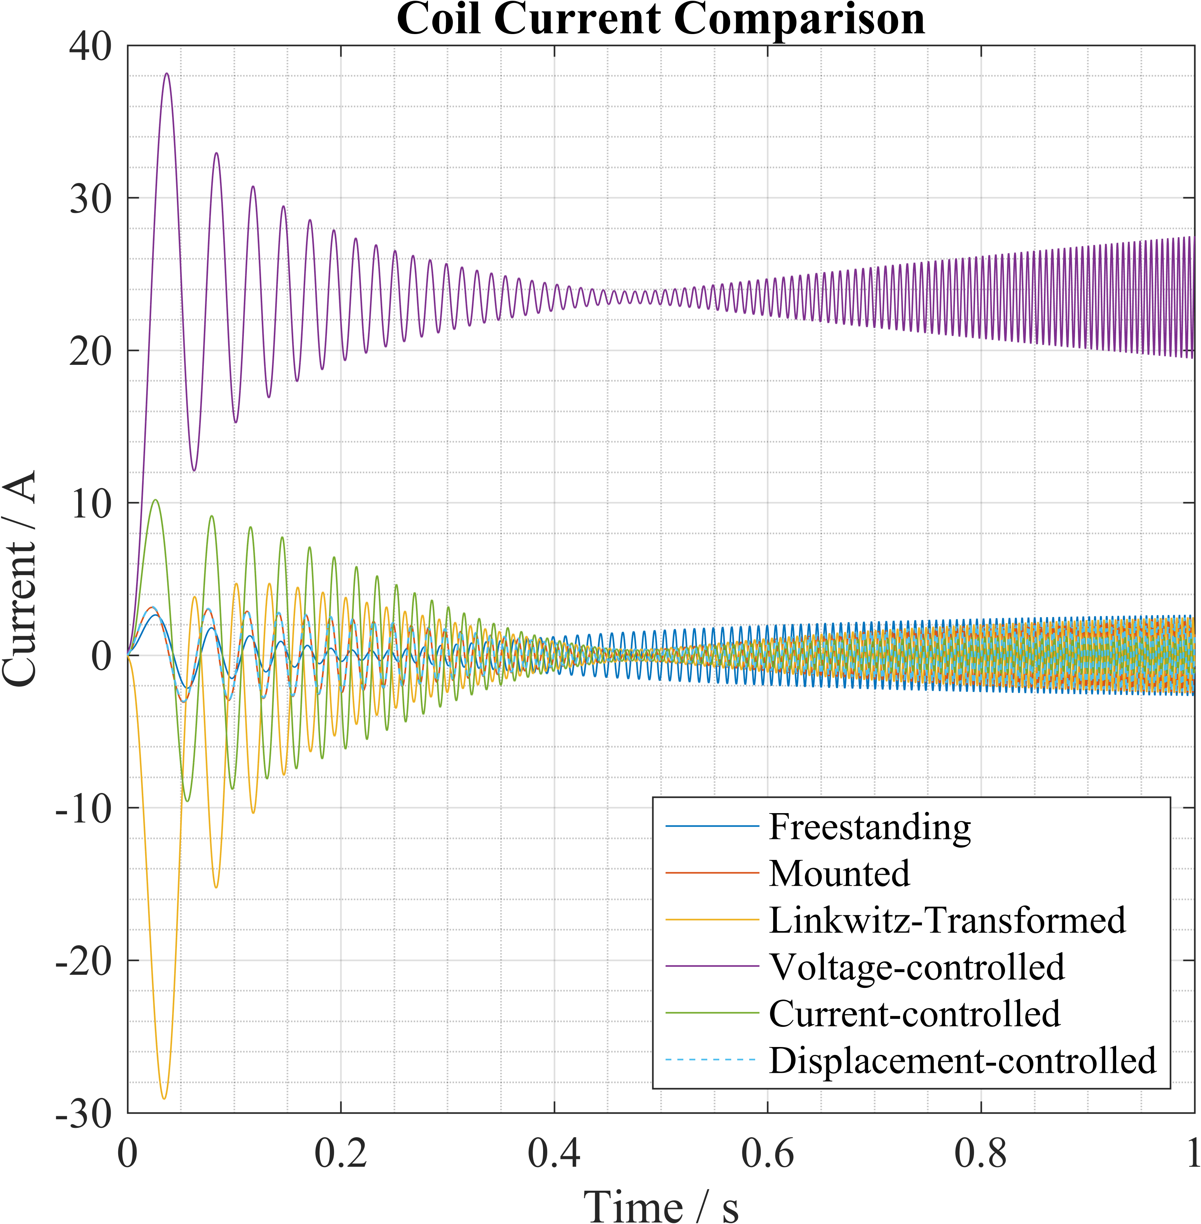
Design/Plots/out_i.png
