spez1998/3rd-year-project/Design/SubsystemImages/LT.png

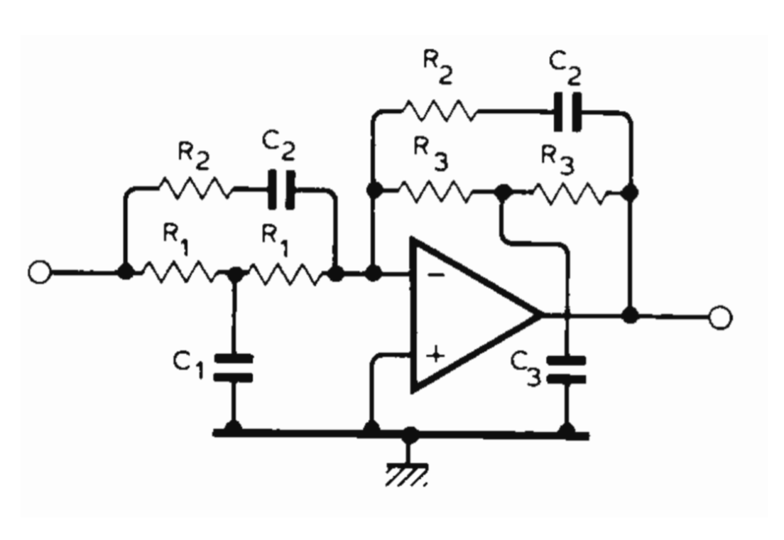
Design/SubsystemImages/LT.png
