spez1998/3rd-year-project/Submissions/FinalArticle/Images/linkwitz_transform.png

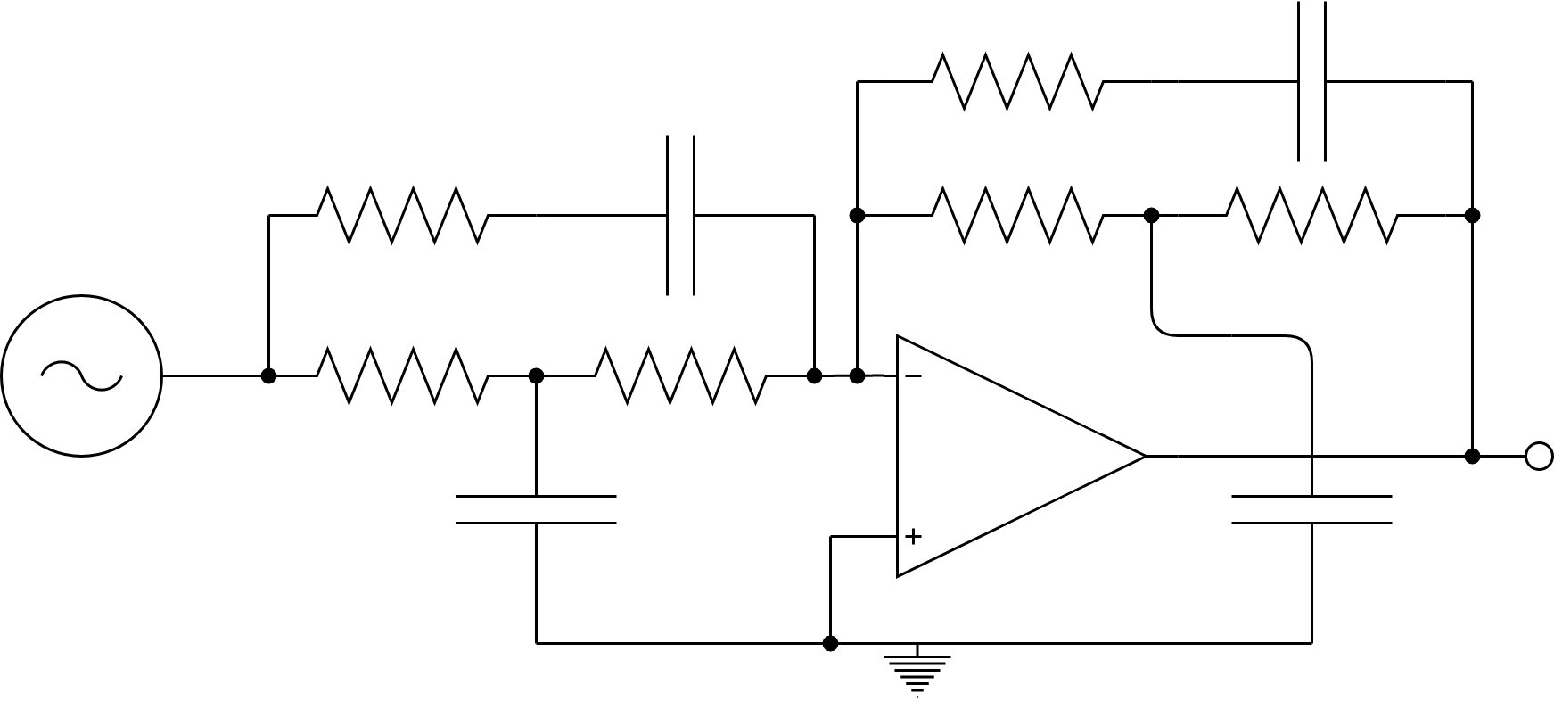
Submissions/FinalArticle/Images/linkwitz_transform.png
