spez1998/3rd-year-project/Submissions/FinalArticle/Images/out_disp.png

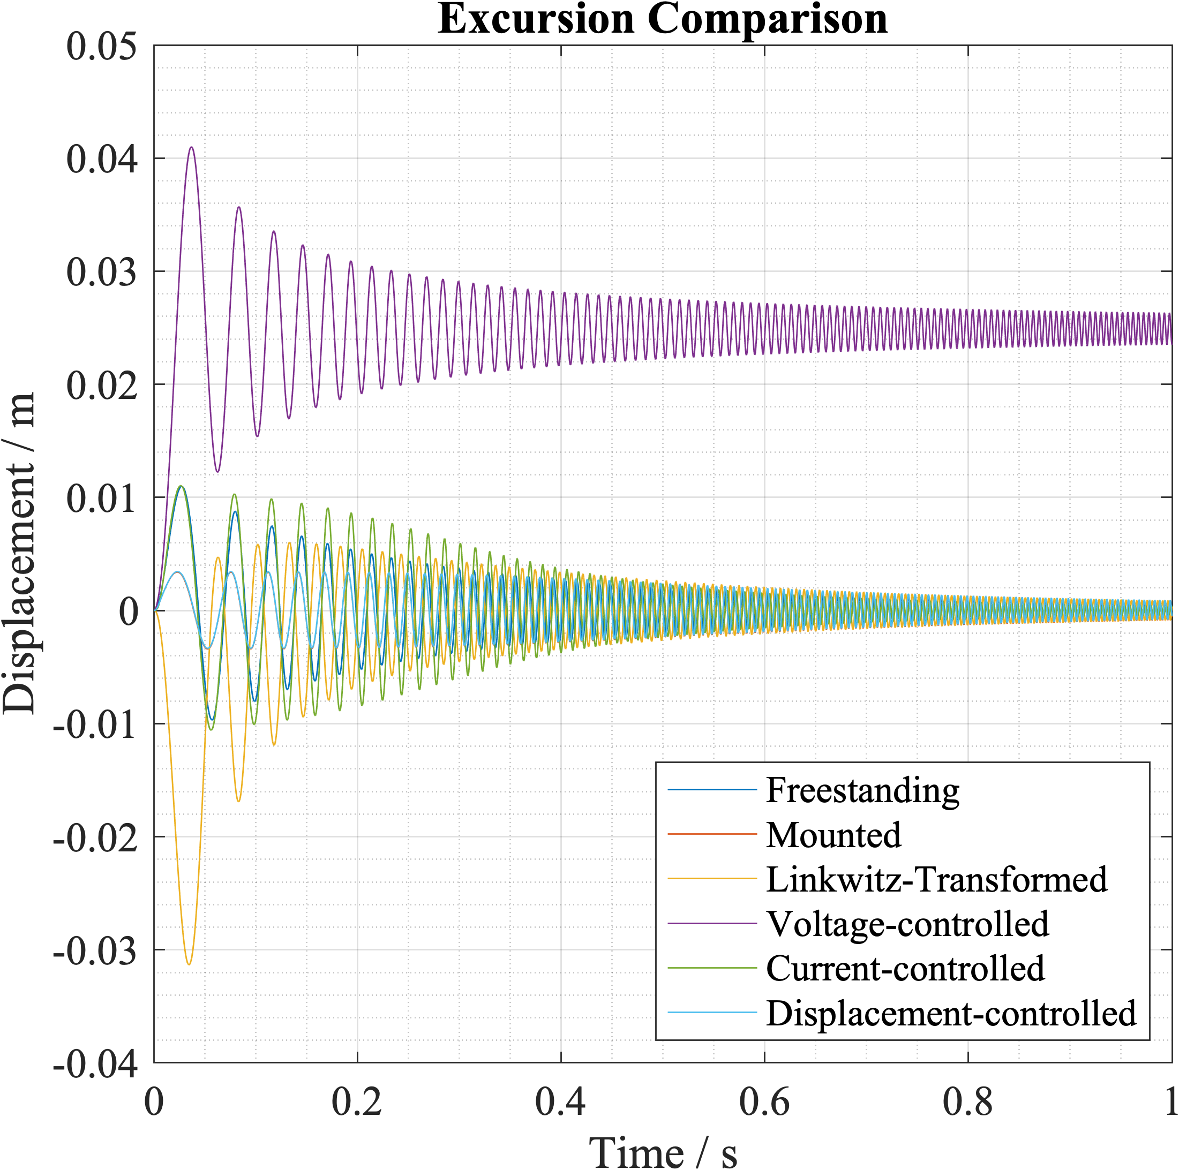
Submissions/FinalArticle/Images/out_disp.png
