spez1998/3rd-year-project/Submissions/FinalArticle/Images/out_disp_pks.png

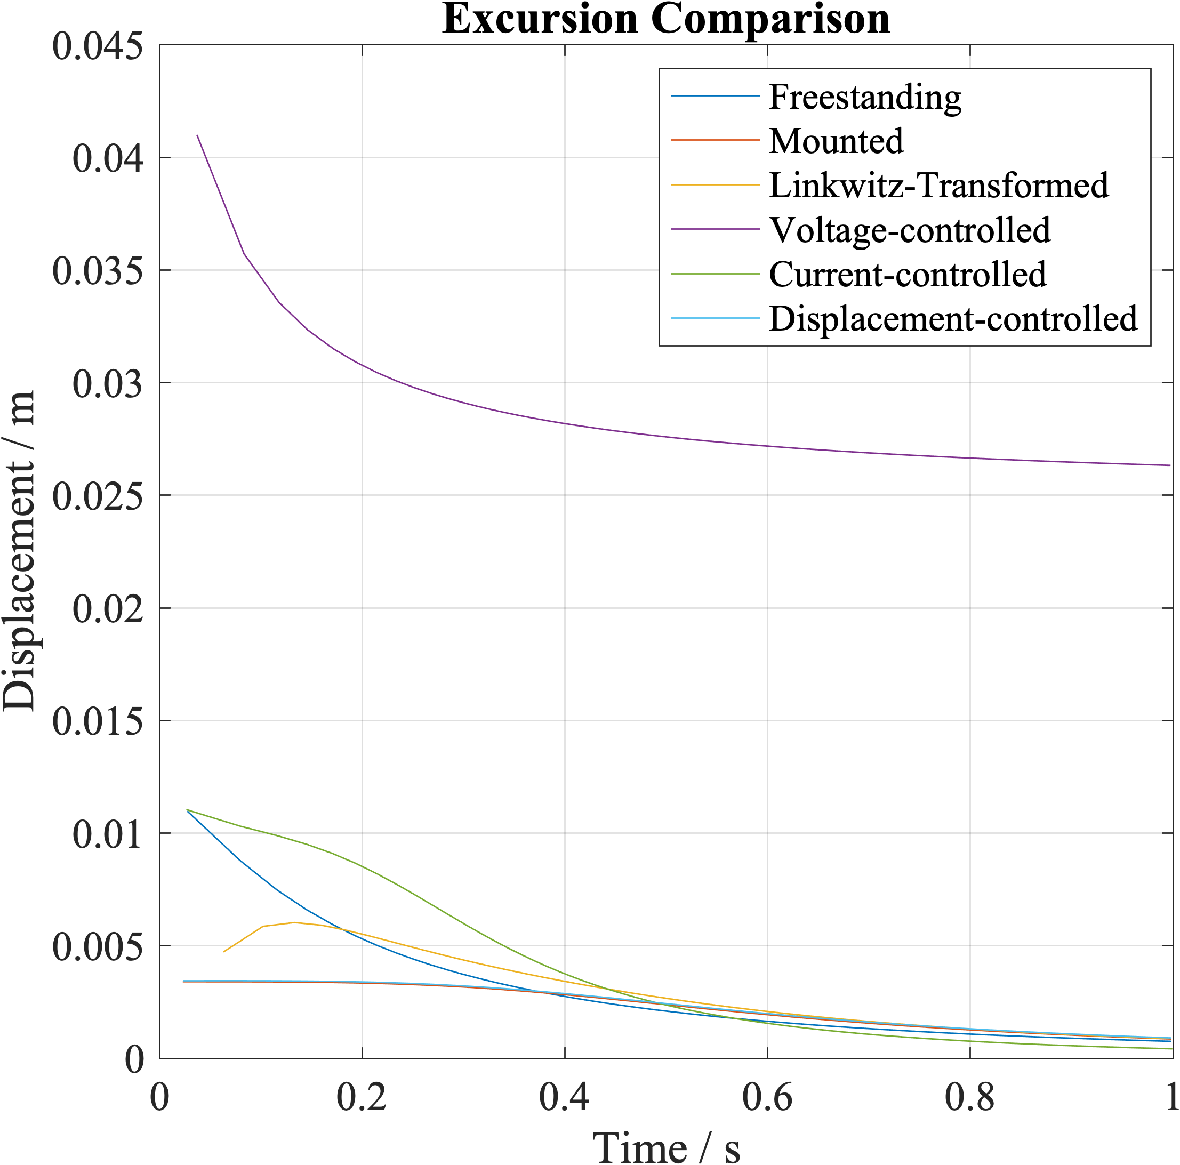
Submissions/FinalArticle/Images/out_disp_pks.png
