spez1998/3rd-year-project/Submissions/FinalArticle/Images/out_v_pks.png

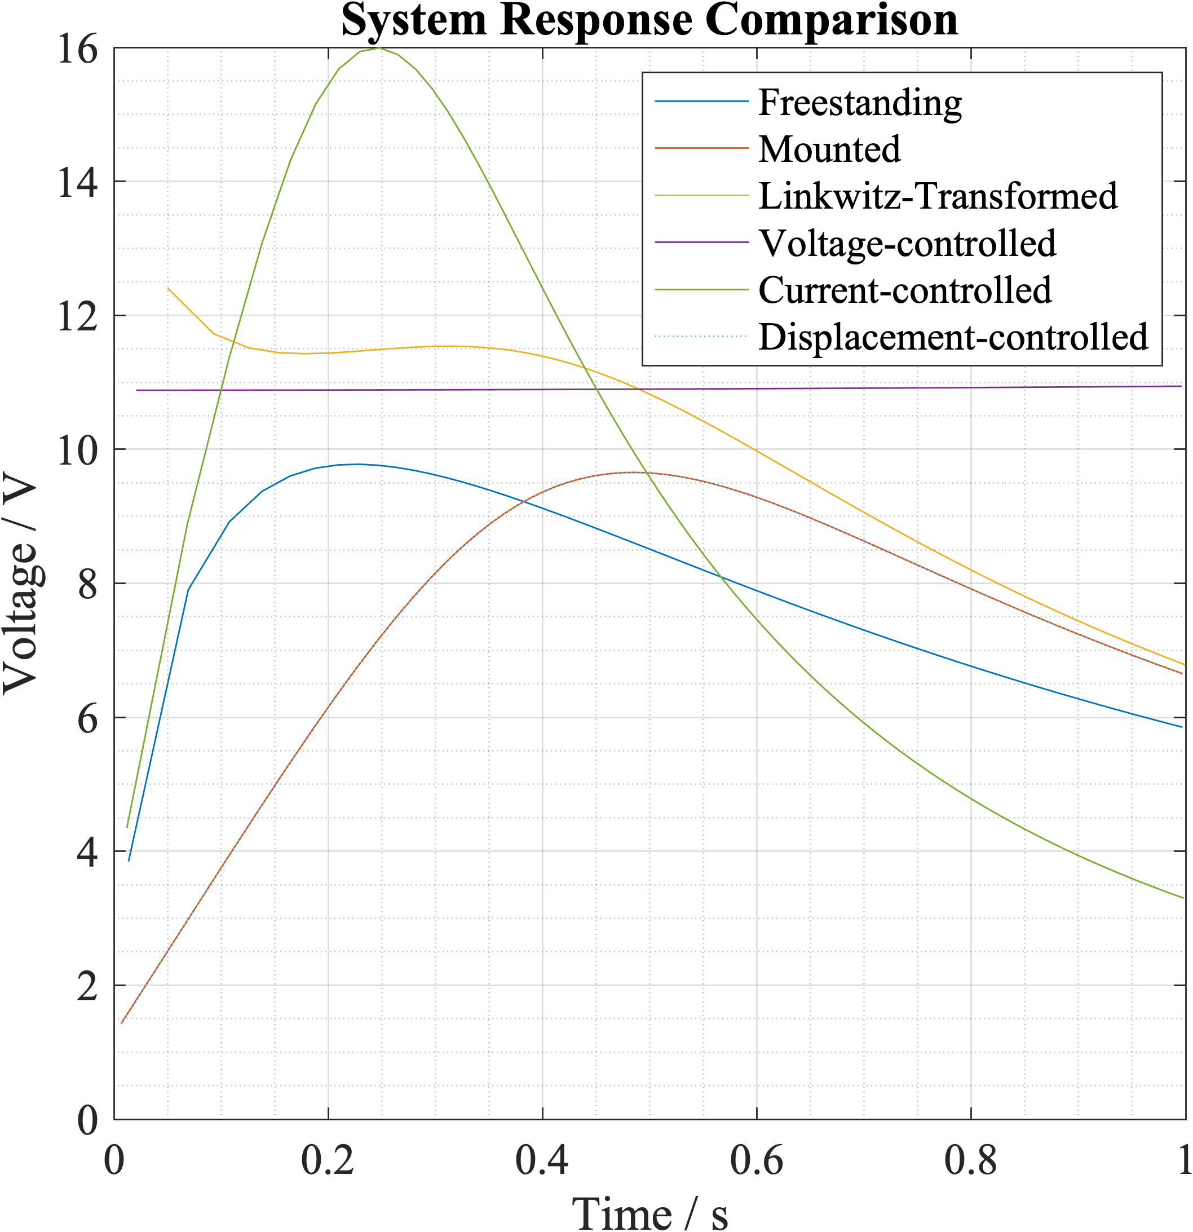
Submissions/FinalArticle/Images/out_v_pks.png
