spez1998/3rd-year-project/Submissions/FinalArticle/Images/prof_foster.png

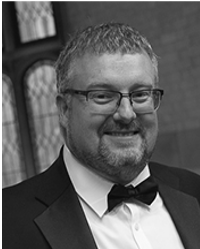
Submissions/FinalArticle/Images/prof_foster.png
