spez1998/3rd-year-project/Submissions/FinalArticle/Images/pyle_enclosure.png

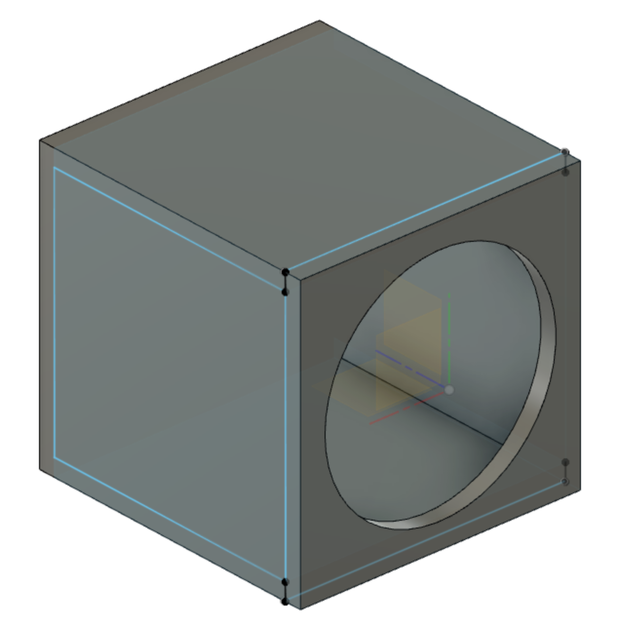
Submissions/FinalArticle/Images/pyle_enclosure.png
