spez1998/3rd-year-project/Submissions/FinalArticle/Images/s_malde.png

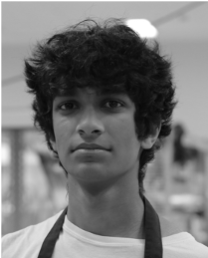
Submissions/FinalArticle/Images/s_malde.png
