spez1998/3rd-year-project/Datasheets/BOM.docx

Amplifier

Probably going to buy LEPY 2024A Plus Amplifier (£26.69 as of 28/10/19):

- Class T (i.e. Class D operation with proprietary improvements for better control of PWM signal)
- Tone/direct switch (will just use DI)
- Some safety mechanisms built-in to reduce headaches when prototyping
- Standalone circuit with Linkwitz Transform filter potential

Only 20W!

Op-amps

Probably want to standardise across all ccts.

Driver

Pyle PL1090BL 10-inch 1kW DVC Subwoofer

Pyle PLPW6D – datasheet exists!
