spez1998/3rd-year-project/RealWorldMeasurements/PyleBodes/CSV/Speaker 1 - Anti-Parallel_2019-11-20T00_31_39.csv

Frequency (Hz) | Trace 1: Impedance: Real (Ω) | Trace 1: Impedance: Imaginary (Ω) | Trace 1: Impedance: Magnitude (Ω) | Trace 2: Impedance: Real (Ω) | Trace 2: Impedance: Imaginary (Ω) | Trace 2: Impedance: Phase (°)
10 | -526696.169027055 | -12956487.1505098 | 12967188.1352818 | -526696.169027055 | -12956487.1505098 | -92.3278579110834
10.191839 | -290764.737126501 | -12289789.5190274 | 12293228.6464684 | -290764.737126501 | -12289789.5190274 | -91.3553108359298
10.387359 | -93564.4075605307 | -11688420.9734907 | 11688795.4534203 | -93564.4075605307 | -11688420.9734907 | -90.458636044864
10.58663 | -1282937.33737169 | -12372656.2485422 | 12438993.1608717 | -1282937.33737169 | -12372656.2485422 | -95.9199200071691
10.789723 | -381276.366760009 | -12481940.3791451 | 12487762.3014046 | -381276.366760009 | -12481940.3791451 | -91.7496266839866
10.996713 | -851193.887279285 | -11528382.2723796 | 11559763.3562222 | -851193.887279285 | -11528382.2723796 | -94.2227505252114
11.207673 | 253464.676208312 | -11711580.6931048 | 11714323.1419144 | 253464.676208312 | -11711580.6931048 | -88.760185337197
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
