spez1998/3rd-year-project/RealWorldMeasurements/PyleBodes/CSV/Speaker 1 - Channel a_2019-11-20T00_30_28.csv

Frequency (Hz) | Trace 1: Impedance: Real (Ω) | Trace 1: Impedance: Imaginary (Ω) | Trace 1: Impedance: Magnitude (Ω) | Trace 2: Impedance: Real (Ω) | Trace 2: Impedance: Imaginary (Ω) | Trace 2: Impedance: Phase (°)
10 | 3.24031102335592 | 0.451962244833817 | 3.27167929339615 | 3.24031102335592 | 0.451962244833817 | 7.94045077691803
10.018579 | 3.23539923588409 | 0.449660451971039 | 3.26649701325842 | 3.23539923588409 | 0.449660451971039 | 7.91236519479438
10.037192 | 3.23443698226062 | 0.453590878181776 | 3.26608745703248 | 3.23443698226062 | 0.453590878181776 | 7.98298256081038
10.05584 | 3.23131488181788 | 0.453352324748343 | 3.26296248765021 | 3.23131488181788 | 0.453352324748343 | 7.98644795775502
10.074522 | 3.23945738810015 | 0.453041232502387 | 3.27098311332601 | 3.23945738810015 | 0.453041232502387 | 7.96123513375315
10.093239 | 3.23251783853756 | 0.455835733313486 | 3.26449962356086 | 3.23251783853756 | 0.455835733313486 | 8.02667847390512
10.111991 | 3.23589273430648 | 0.454248146807148 | 3.26762041351427 | 3.23589273430648 | 0.454248146807148 | 7.99085070282954
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
