spez1998/3rd-year-project/RealWorldMeasurements/PyleBodes/CSV/Speaker 1 - Channel b_2019-11-20T00_33_24.csv

Frequency (Hz) | Trace 1: Impedance: Real (Ω) | Trace 1: Impedance: Imaginary (Ω) | Trace 1: Impedance: Magnitude (Ω) | Trace 2: Impedance: Real (Ω) | Trace 2: Impedance: Imaginary (Ω) | Trace 2: Impedance: Phase (°)
10 | 3.28183024597929 | 0.426622308503183 | 3.30944351176101 | 3.28183024597929 | 0.426622308503183 | 7.40664389923698
10.018579 | 3.2840992078181 | 0.418159273348572 | 3.31061395887211 | 3.2840992078181 | 0.418159273348572 | 7.2563365748114
10.037192 | 3.27964246285364 | 0.414843283240604 | 3.30577519408119 | 3.27964246285364 | 0.414843283240604 | 7.2090806855924
10.05584 | 3.27999303681905 | 0.416096043975133 | 3.30628042358679 | 3.27999303681905 | 0.416096043975133 | 7.22985624779307
10.074522 | 3.27403931310439 | 0.420875761601154 | 3.30098013178759 | 3.27403931310439 | 0.420875761601154 | 7.32516456083118
10.093239 | 3.27935895541309 | 0.423318868603549 | 3.30656831518174 | 3.27935895541309 | 0.423318868603549 | 7.35540016726103
10.111991 | 3.27806688849809 | 0.424109822078107 | 3.30538827774449 | 3.27806688849809 | 0.424109822078107 | 7.37186509054498
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
