spez1998/3rd-year-project/RealWorldMeasurements/PyleBodes/CSV/Speaker 1 - Parallel_2019-11-20T00_33_41.csv

Frequency (Hz) | Trace 1: Impedance: Real (Ω) | Trace 1: Impedance: Imaginary (Ω) | Trace 1: Impedance: Magnitude (Ω) | Trace 2: Impedance: Real (Ω) | Trace 2: Impedance: Imaginary (Ω) | Trace 2: Impedance: Phase (°)
10 | 12751.4400867554 | -12283450.3874529 | 12283457.006081 | 12751.4400867554 | -12283450.3874529 | -89.9405213181806
10.191839 | -15957.0868581638 | -12256100.3366243 | 12256110.7244518 | -15957.0868581638 | -12256100.3366243 | -90.0745973995465
10.387359 | -473585.528524477 | -12379680.8852752 | 12388736.0967161 | -473585.528524477 | -12379680.8852752 | -92.1907856305133
10.58663 | -1040621.46724593 | -11856540.5174255 | 11902119.3944375 | -1040621.46724593 | -11856540.5174255 | -95.0158666279926
10.789723 | -289977.286732957 | -11252320.549482 | 11256056.3509213 | -289977.286732957 | -11252320.549482 | -91.4762108934092
10.996713 | -474702.320825967 | -11791821.2820149 | 11801372.438847 | -474702.320825967 | -11791821.2820149 | -92.3053063949204
11.207673 | -369165.585623562 | -12324910.6884393 | 12330438.2204208 | -369165.585623562 | -12324910.6884393 | -91.7156560722842
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
