spez1998/3rd-year-project/RealWorldMeasurements/PyleBodes/CSV/Speaker 2  - Anti-Parallel_2019-11-20T00_34_50.csv

Frequency (Hz) | Trace 1: Impedance: Real (Ω) | Trace 1: Impedance: Imaginary (Ω) | Trace 1: Impedance: Cs (F) | Trace 2: Impedance: Real (Ω) | Trace 2: Impedance: Imaginary (Ω) | Trace 2: Impedance: Phase (°)
10 | 5301292.11278558 | -11639687.9391856 | 1.36734716534876E-09 | 5301292.11278558 | -11639687.9391856 | -65.5131229710627
10.191839 | 4680827.98998752 | -12025667.6177515 | 1.29854911649917E-09 | 4680827.98998752 | -12025667.6177515 | -68.7321995140278
10.387359 | 3531429.26558396 | -11277441.9763187 | 1.35863997537153E-09 | 3531429.26558396 | -11277441.9763187 | -72.6125232582261
10.58663 | 3960223.57367637 | -11942550.5515015 | 1.2588248526772E-09 | 3960223.57367637 | -11942550.5515015 | -71.6541599883469
10.789723 | 4650283.68602074 | -11625632.2520067 | 1.26880024917762E-09 | 4650283.68602074 | -11625632.2520067 | -68.1984597190224
10.996713 | 4492546.75835921 | -12174498.4328609 | 1.18879279112614E-09 | 4492546.75835921 | -12174498.4328609 | -69.7452895356508
11.207673 | 3364051.85677513 | -11756719.9887484 | 1.20786530221526E-09 | 3364051.85677513 | -11756719.9887484 | -74.0321279595793
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
