spez1998/3rd-year-project/RealWorldMeasurements/PyleBodes/CSV/Speaker 2  - Parallel_2019-11-20T00_35_07.csv

Frequency (Hz) | Trace 1: Impedance: Real (Ω) | Trace 1: Impedance: Imaginary (Ω) | Trace 1: Impedance: Cs (F) | Trace 2: Impedance: Real (Ω) | Trace 2: Impedance: Imaginary (Ω) | Trace 2: Impedance: Phase (°)
10 | 4592392.03608363 | -12260105.8910595 | 1.29815308698073E-09 | 4592392.03608363 | -12260105.8910595 | -69.4650486577444
10.191839 | 4515606.58309246 | -11573672.5140254 | 1.34926230558364E-09 | 4515606.58309246 | -11573672.5140254 | -68.6861630211439
10.387359 | 5532338.47257404 | -12424969.2465367 | 1.23316067709627E-09 | 5532338.47257404 | -12424969.2465367 | -65.9985154716642
10.58663 | 3559560.39800676 | -12034966.6199624 | 1.24915838267866E-09 | 3559560.39800676 | -12034966.6199624 | -73.52345839536
10.789723 | 4646365.66529403 | -11228172.8141535 | 1.31371375755812E-09 | 4646365.66529403 | -11228172.8141535 | -67.519584487157
10.996713 | 4419678.35211301 | -11600749.0516456 | 1.2475880572995E-09 | 4419678.35211301 | -11600749.0516456 | -69.1440523360555
11.207673 | 4611550.5872348 | -11969396.8194846 | 1.18640348853279E-09 | 4611550.5872348 | -11969396.8194846 | -68.9294014873149
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
