spez1998/3rd-year-project/RealWorldMeasurements/PyleBodes/Plots/s3_mag_comps.png

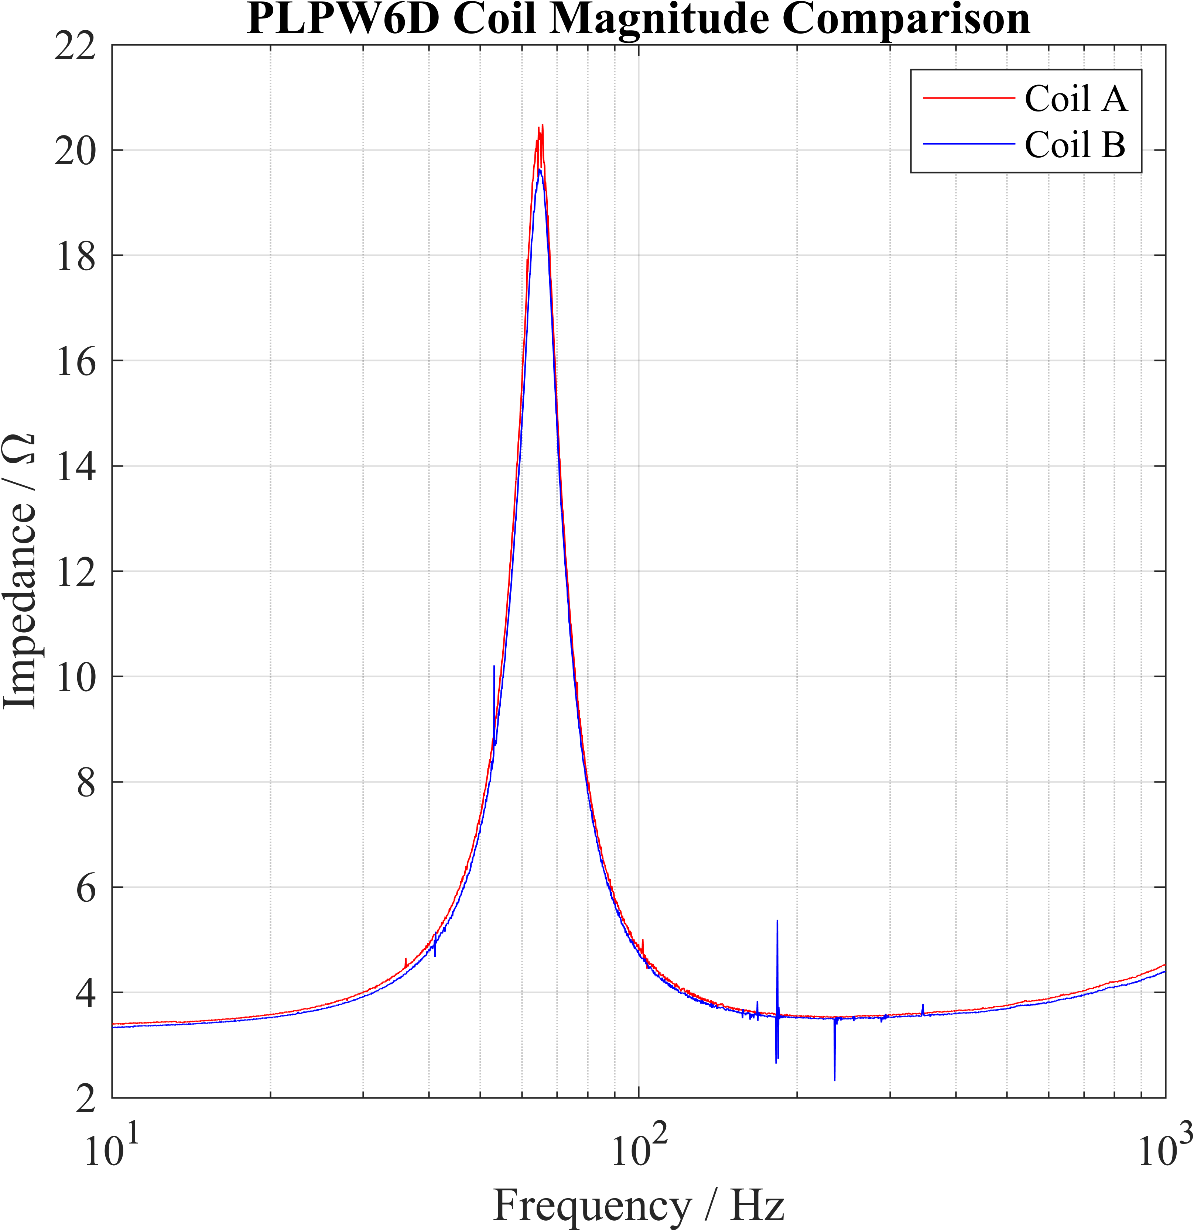
RealWorldMeasurements/PyleBodes/Plots/s3_mag_comps.png
