spez1998/3rd-year-project/RealWorldMeasurements/PyleBodes/Plots/speaker_3_channel_a.png

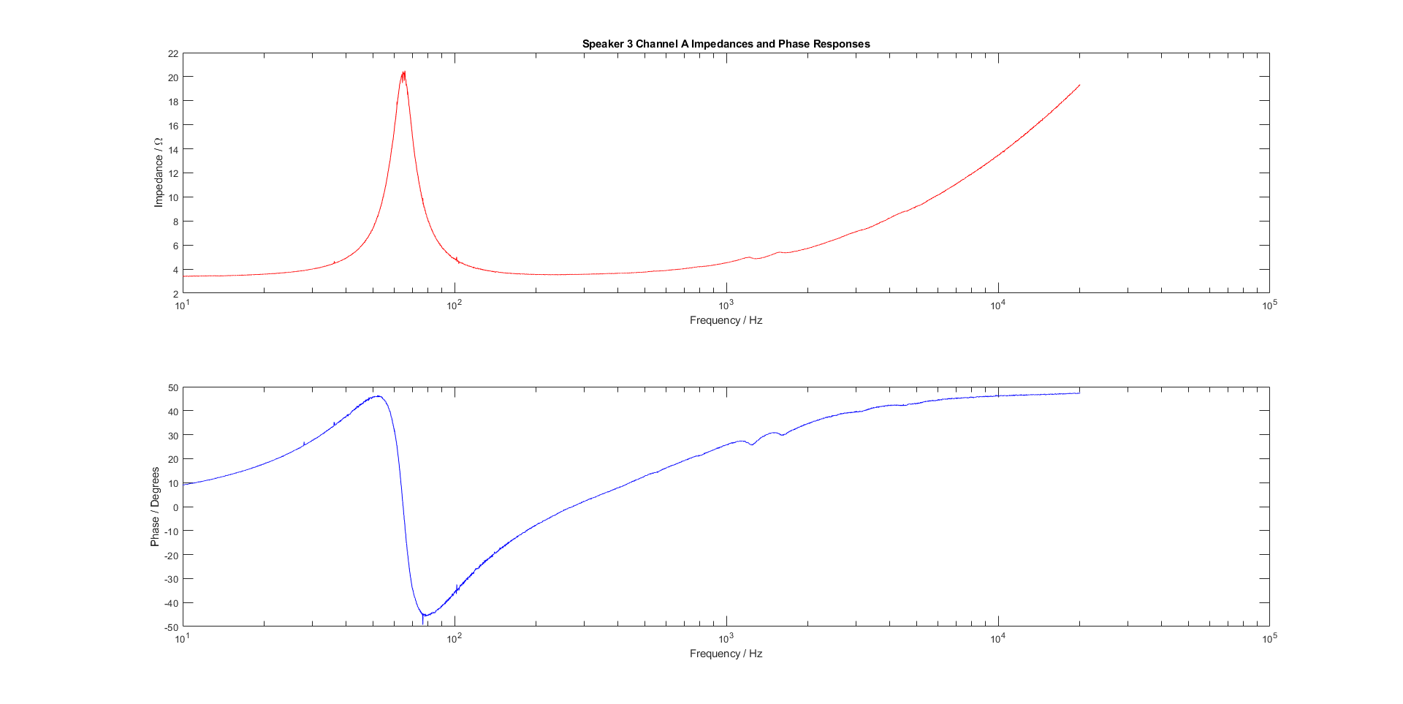
RealWorldMeasurements/PyleBodes/Plots/speaker_3_channel_a.png
