spez1998/3rd-year-project/RealWorldMeasurements/PyleBodes/Plots/speaker_3_channel_b.png

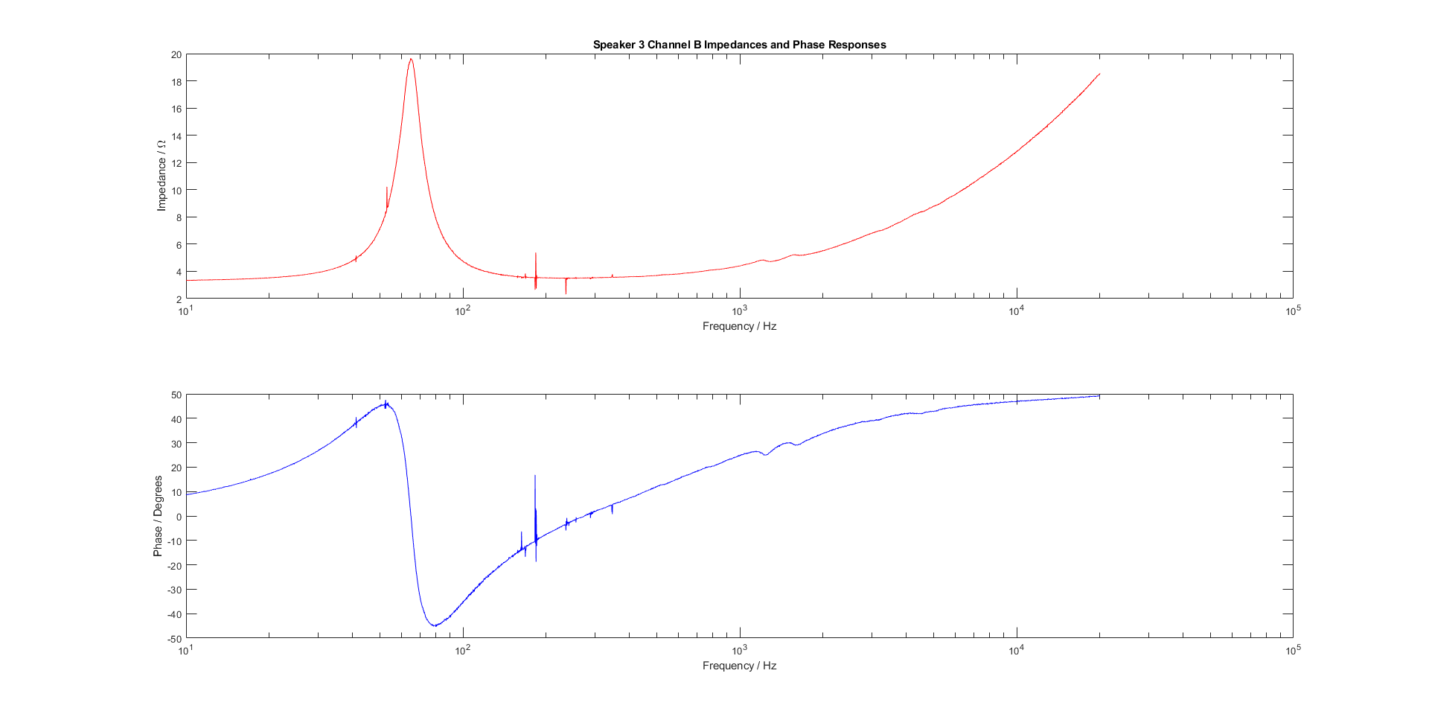
RealWorldMeasurements/PyleBodes/Plots/speaker_3_channel_b.png
