spez1998/3rd-year-project/RealWorldMeasurements/PyleBodes/Plots/speaker_3_coils_mag_comp.png

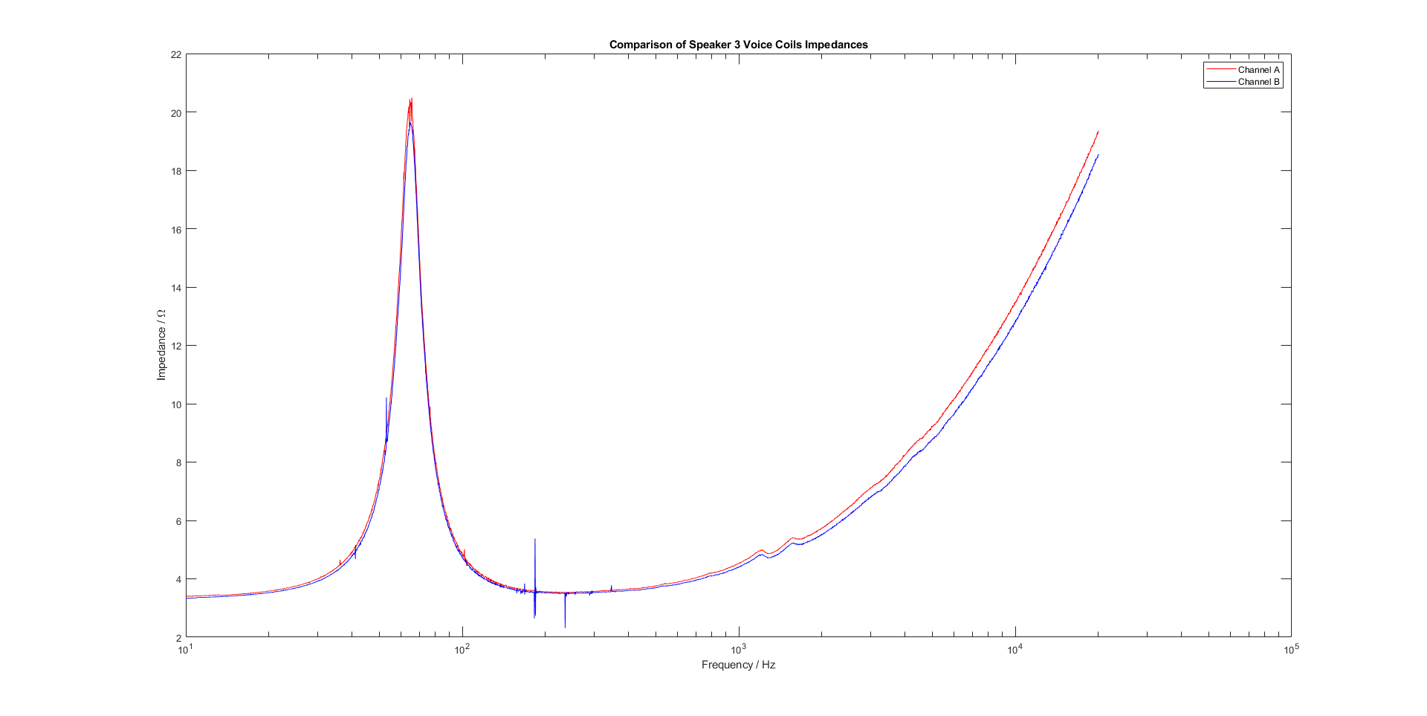
RealWorldMeasurements/PyleBodes/Plots/speaker_3_coils_mag_comp.png
