spez1998/3rd-year-project/Design/ClosedLoop/Simulations/LTspice/mounted_pyle.asc

C1: cap; 2.2n
C2: cap; 150n
C3: cap; 6.8n
C4: cap; 15n
C5: cap; 388.95µ
C6: cap; 47n
C7: cap; 47n
C8: cap; 47n
C9: cap; 470p
C10: cap; 388.95µ
L1: ind; 9m
L2: ind; 23.9m
L3: ind; 23.9m
L4: ind; 148.8µ
L5: ind; 148.8µ
L6: ind; 9m
R1: res; 28.42
R2: res; 3.4
R3: res; 15.4k
R4: res; 15.4k
R5: res; 13.3k
R6: res; 442k
R7: res; 442k
R8: res; 13.3k
R9: res; 28.42
R10: res; 3.4
R11: res; 282
R15: res; 282
U2: TL074
V1: voltage; ""; AC 1
V2: voltage; ""; AC 1
V3: voltage; 15V
V4: voltage; 15V
Named nets: 0, 15V, -15V
.ac dec 10000 1 1000
5.7367 litre box, fp = 101.52Hz, Q = 0.722
LT --> fnew = 19Hz, Qnew = 0.19
