spez1998/3rd-year-project/Design/OpenLoop/Simulations/LTspice/LinkwitzTHOR/mounted_thor.asc

C1: cap; 536.9µ
C2: cap; 536.9µ
L1: ind; 4.2m
L2: ind; 35.6m
L3: ind; 4.2m
L4: ind; 35.6m
L5: ind; 47.5m
R1: res; 3.5
R2: res; 54.4
R3: res; 3.5
R4: res; 54.4
R5: res; 543
V1: voltage; ""; AC 1
V2: voltage; ""; AC 1
Named nets: 0
.ac dec 10000 1 1000
.ac dec 10000 1 1000
