spez1998/3rd-year-project/Design/OpenLoop/Simulations/LTspice/LinkwitzTHOR/thor_comp.asc

C1: cap; 0.68n
C2: cap; 82n
C3: cap; 39n
C4: cap; 0.68n
C5: cap; 22n
C6: cap; 536.9µ
C7: cap; 22n
C8: cap; 4.7n
C9: cap; 2.2n
C10: cap; 537µ
C11: cap; 330n
C12: cap; 330n
C13: cap; 570n
C14: cap; 536.9µ
L1: ind; 35.6m
L2: ind; 4.2m
L3: ind; 36m
L4: ind; 4.2m
L5: ind; 35.6m
R1: res; 100k
R2: res; 100k
R3: res; 287k
R4: res; 210k
R5: res; 210k
R6: res; 287k
R7: res; 54.4
R8: res; 3.5
R9: res; 3.5
R10: res; 54
R11: res; 10k
R12: res; 21.5k
R13: res; 10k
R14: res; 2.15k
R15: res; 2.15k
R16: res; 33.7k
R17: res; 10k
R18: res; 196
R19: res; 3.5
R20: res; 54.4
U1: UniversalOpamp2
U2: UniversalOpamp2
U3: UniversalOpamp2
U4: UniversalOpamp2
V1: voltage; ""; PULSE(0 1 0 .001 .001 0.5 1)
V2: voltage; ""; PULSE(0 1 0 .001 .001 0.5 1)
V3: voltage; ""; PULSE(0 1 0 .001 .001 0.5 1)
V4: voltage; 50V
V5: voltage; 50V
Named nets: 0, 50V, -50V
.ac dec 10000 1 1000
Simple EQ circuit
Linkwitz Transform
.tran 5
