spez1998/3rd-year-project/Design/OpenLoop/Simulations/LTspice/PylePLPW6D/unmounted_pyle_lt_tl074_bad.asc

C1: cap; 47n
C2: cap; 47n
C3: cap; 47n
C4: cap; 33n
C5: cap; 388.95µ
C6: cap; 388.95µ
C7: cap; 2.2n
C8: cap; 1µ
C9: cap; 100n
C10: cap; 2.2n
C14: cap; 3.3n
C15: cap; 2.2n
C16: cap; 47n
C17: cap; 6.8n
L1: ind; 23.9m
L2: ind; 148.8µ
L3: ind; 23.9m
L4: ind; 148.8µ
R1: res; 28.42
R2: res; 3.4
R3: res; 28.42
R4: res; 3.4
R6: res; 536k
R7: res; 536k
R8: res; 7.5k
R9: res; 13.3k
R10: res; 13.3k
R11: res; 133k
R12: res; 105k
R13: res; 105k
R14: res; 133k
U1: TL074
U2: TL074
U4: UniversalOpamp2
V1: voltage; 15V
V2: voltage; 15V
V3: voltage; ""; AC 1
V4: voltage; ""; AC 1
V6: voltage; ""
Named nets: 0, 15V, -15V
.ac dec 1000 1 20000
