spez1998/3rd-year-project/Design/OpenLoop/Simulations/LTspice/LinkwitzTHOR/lt_thor.asc

C1: cap; 22n
C2: cap; 4.7n
C3: cap; 2.2n
C4: cap; 536.9µ
C7: cap; 0.68n
C8: cap; 82n
C9: cap; 39n
C10: cap; 0.68n
C11: cap; 22n
C12: cap; 536.9µ
L1: ind; 35.6m
L2: ind; 35.6m
L3: ind; 4.2m
L4: ind; 4.2m
R1: res; 54.4
R2: res; 3.5
R9: res; 100k
R10: res; 100k
R11: res; 287k
R12: res; 210k
R13: res; 210k
R14: res; 287k
R15: res; 54.4
R16: res; 3.5
U3: UniversalOpamp2
V1: voltage; 50V
V2: voltage; 50V
V3: voltage; 0; AC 1
V4: voltage; 0; AC 1
Named nets: 0, 50V, -50V
.ac dec 10000 1 1000
