spez1998/3rd-year-project/Design/OpenLoop/Simulations/LTspice/LinkwitzTHOR/thor.asc

C1: cap; 536.9µ
L1: ind; 4.2m
L2: ind; 35.6m
R1: res; 3.5
R2: res; 54.4
V1: voltage; ""; AC 1
Named nets: 0
.ac dec 10000 1 1000
