spez1998/3rd-year-project/(commit log)

2019-10-15 Initial commit of all files.
    Expect directories to change regularly. Try to keep everything synced across desktop and laptop.
    [closed-box1.xls, spl_max1.xls]
2019-10-20 Better structure to PID
2019-10-22 More robust derivation of equivalent circuit parameters.
2019-10-23 Replacing for PID FINAL
2019-10-23 .xlsx and .png of Gantt chart
    [Gantt chart.xlsx]
2019-10-25 Finished PID, exported as pdf
2019-10-25 Finished PID
2019-10-25 Testing working with branches by simple restructure
    [Gantt chart.xlsx]
2019-10-25 Updated file path of PID
2019-10-28 Add BOM thoughts to log book
2019-10-28 Try finding a better driver
2019-10-29 Playing with Linkwitz Labs THOR simulation
    [closed-box1.xls, spl_max1.xls]
2019-10-30 Playing with S. Linkwitz's spreadsheets
    [closed-box1.xls, spl_max1.xls]
2019-11-04 Cleaning up Simulations directory
    [closed-box1.xls]
2019-11-07 Spreadsheet to calculate Linkwitz Transform circuit values
    [pz-eql.xls]
2019-11-07 Playing with spreadsheet
    [pz-eql.xls]
2019-11-09 Calculated equivalent circuit for Pyle DVC subwoofer
    [closed-box1.xls]
2019-11-09 Deriving equivalent circuit for Pyle PLPW6D DVC subwoofer
    [closed-box1.xls]
2019-11-09 Designing Linkwitz Transform filter for Pyle subwoofer
    [closed-box1.xls, pz-eql.xls]
2019-11-10 Pyle subwoofer simulation filtered fairly linear
    [closed-box1.xls]
2019-11-11 Restructured file system.
    [closed-box1.xls, closed_box.xls, gantt_chart.xlsx, lt_designer.xls, spl_max.xls]
2019-11-11 Changed PID path location to reflect filesystem restructure
2019-11-11 Created csv data file for simulation
    [dual_full_lt_pyle_notch_tl074.csv]
2019-11-12 Updated simulations, added basic with notch filter
2019-11-12 Added MATLAB plotter and some csv data.
    [dual_full_lt_pyle_notch_tl074.csv]
2019-11-12 Added simulation for LT subwoofer without notch filter.
2019-11-12 Trying to adapt notch filter to non-LT conditions.
2019-11-12 Creating graphs of open-loop responses.
    [basic_pyle.csv, dual_full_lt_pyle.csv, dual_full_lt_pyle_notch_tl074.csv]
2019-11-19 Corrected Pyle PLPW6D equivalent circuits based on MPF meetings.
    [closed_box.xls]
2019-11-20 Exported Bode3 data as csv files.
    [Speaker 1 - Anti-Parallel_2019-11-20T00_31_39.csv, Speaker 1 - Channel a_2019-11-20T00_30_28.csv, Speaker 1 - Channel b_2019-11-20T00_33_24.csv, Speaker 1 - Parallel_2019-11-20T00_33_41.csv, Speaker 2 - Anti-Parallel_2019-11-20T00_34_50.csv, Speaker 2 - Parallel_2019-11-20T00_35_07.csv, Speaker 2 - Channel a_2019-11-20T00_35_23.csv, Speaker 2 - Channel b_2019-11-20T00_35_45.csv]
2019-11-20 Experimenting with spreadsheets with corrected equivalent circuits.
    [closed_box.xls, lt_designer.xls, spl_max.xls]
2019-11-24 WIP README to replace now obsolete information in current README.
2019-11-24 Just looking
    [closed_box.xls, spl_max.xls]
2019-11-24 Creating Simulink simulation of equivalent circuits for more flexibility.
2019-11-26 Just experimenting
    [closed_box.xls]
2019-11-26 Created MATLAB script to find optimal box volume given Xmax and poweramp specs.
2019-12-04 Experimenting with additional box circuit elements.
2019-12-04 Experimenting with box volume of 6.5 litres.
    [closed_box.xls]
2019-12-10 Keeping original copies of Linkwitz Lab resources for reference.
    [closed-box1-1.xls, spl_max1.xls]
2019-12-11 Finding the best Linkwitz Transform for Pylr PLPW6D.
    [closed-box1-1.xls, closed_box.xls, spl_max.xls]
2019-12-19 Committing to box size 6 litres, construction started.
    [closed_box.xls, spl_max.xls]
2019-12-20 Re-doing all plots and slight reshuffle of new files.
    [basic_pyle.csv, dual_full_lt_pyle.csv, dual_full_lt_pyle_notch_tl074.csv, mounted_pyle.csv, mounted_pyle_lt.csv, unmounted_pyle.csv]
2020-01-02 Writing interim report
    [closed_box.xls]
2020-01-05 Writing interim report. Lots of changes. Too much to commit individually.
    [closed-box1-1.xls, closed_box.xls, mounted_pyle.csv, mounted_pyle_lt.csv, unmounted_pyle.csv]
2020-01-06 Almost finished writing interim report.
    [gantt_chart copy.xlsx, gantt_chart.xlsx, gantt_chart_amended.xlsx]
2020-01-17 Nearly finished interim report.
    [lt_designer.xls]
2020-01-23 Created animation powerpoint.
2020-01-24 Finished animation using powerpoint. Using powerpoint to record audio.
2020-04-23 Major restructure.
    [Speaker 1 - Anti-Parallel_2019-11-20T00_31_39.csv, Speaker 1 - Channel a_2019-11-20T00_30_28.csv, Speaker 1 - Channel b_2019-11-20T00_33_24.csv, Speaker 1 - Parallel_2019-11-20T00_33_41.csv, Speaker 2 - Anti-Parallel_2019-11-20T00_34_50.csv, Speaker 2 - Parallel_2019-11-20T00_35_07.csv, Speaker 2 - Channel a_2019-11-20T00_35_23.csv, Speaker 2 - Channel b_2019-11-20T00_35_45.csv]
2020-04-23 Cleaning up legacy files.
    [basic_pyle.csv, dual_full_lt_pyle.csv, dual_full_lt_pyle_notch_tl074.csv, mounted_pyle.csv, mounted_pyle_lt.csv, unmounted_pyle.csv]
