spez1998/3rd-year-project/(notices)

Notices in the files:
Design/OpenLoop/LinkwitzLabsResources/Originals/closed-box1-1.xls:
Determination of F0, Q0 from a terminal impedance measurement | | | | | | | © LINKWITZ LAB | 7/18/01
